VendeinRaZoR/PCI_COM_LPT/README.md

# COM и LPT контроллеры на шине PCI (2017-2018 годов разработки)

**Краткое описание**

COM и LPT (только в версии 1) контроллеры на шине PCI. Представляют собой функциональные аналоги 
китайских контроллеров типа Orient (только с одним COM портом), выполненные на, как зарубежной,
так и отечественной микросхемах ПЛИС.

Вся документация находится в папках Schematics, а Gerber файлы в папках Gerber. Документации на 
отечественные ПЛИС находятся в папке воронеж ктц.

Проект для импортной ПЛИС EP3CE10 Cyclone III для Quartus 13.0sp1 - в папке Cyclone III

Проект для отечественной ПЛИС 5576ХС4Т для Quartus 9.0sp2 - в папке XC4T

Аналог для версии 1 (WCH CH353):

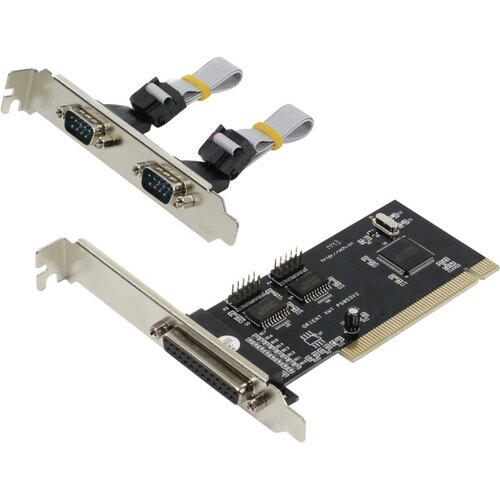
[picture p1: README.images/1.jpg]


Аналог для версии 2 (WCH CH351/353):

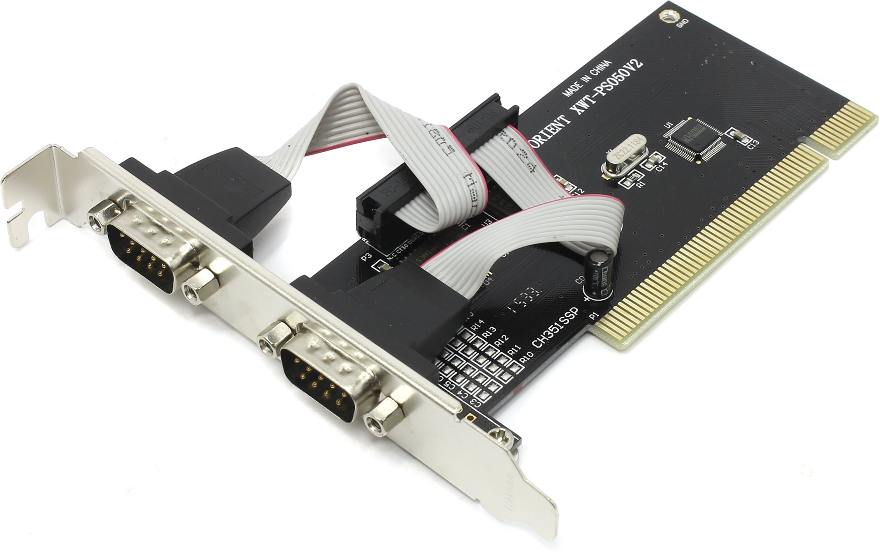
[picture p2: README.images/2.jpg]


Драйвера также используются исключительно от данных контроллеров и находятся в папке Drivers.

Внешний вид аналога на импортной ПЛИС (Cyclone III):

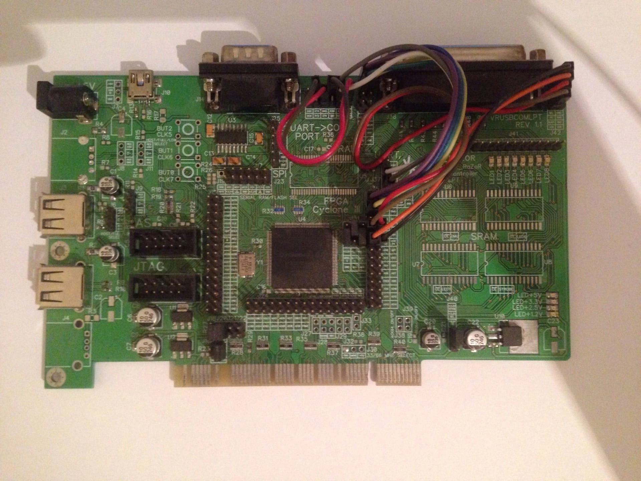
[picture p3: README.images/3.jpg]


Внешний вид аналога на отечественной ПЛИС (5576ХС4Т, Воронеж, КТЦ Электроника):

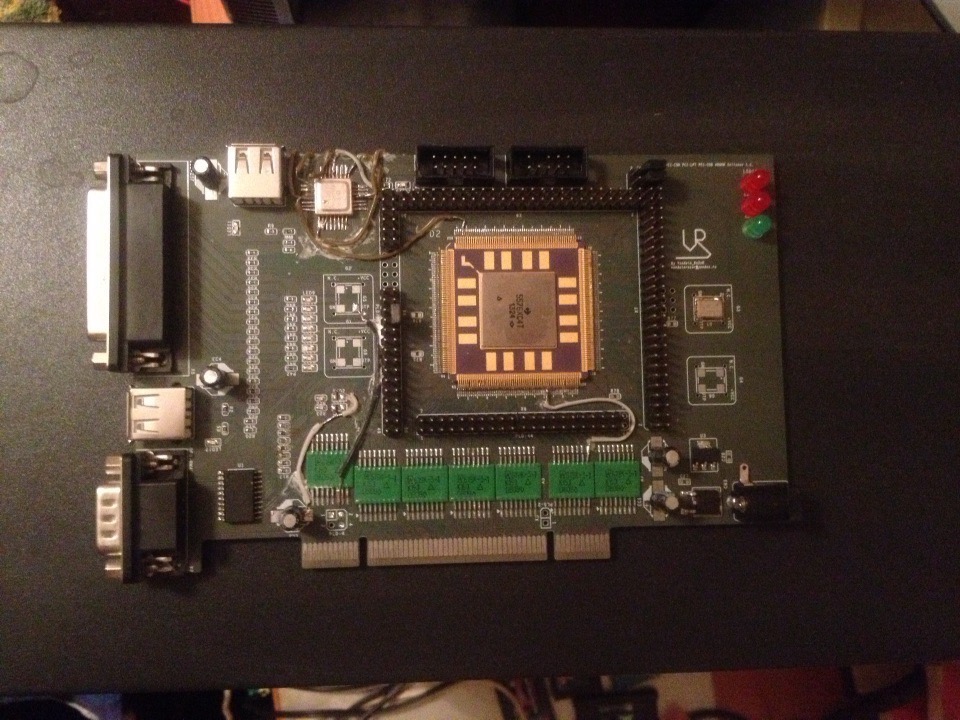
[picture p4: README.images/4.jpg]

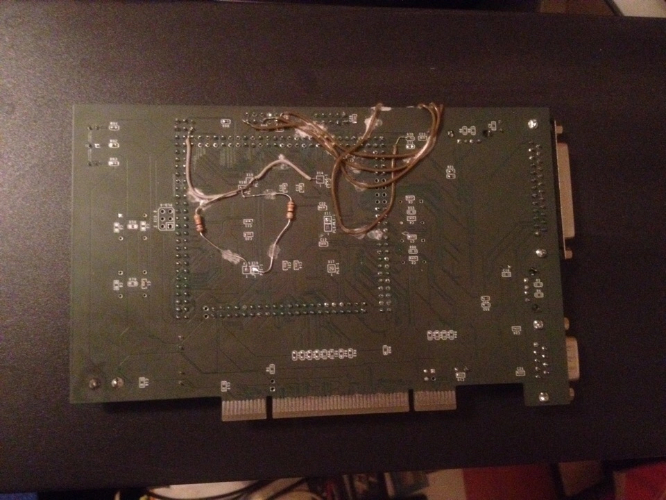
[picture p5: README.images/5.jpg]

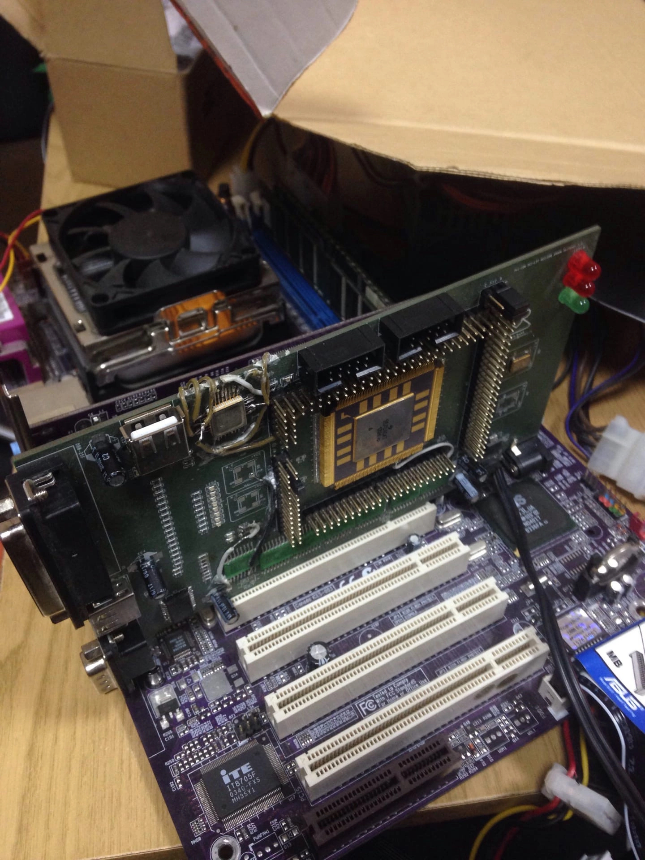
[picture p6: README.images/6.jpg]


***Видео примера работы устройства***

Watch the video (https://youtu.be/Nd93BykMgdI)
