VendeinRaZoR/PCI_COM_LPT/Schematics Cyclone III/Плакат демонстрационный.pdf

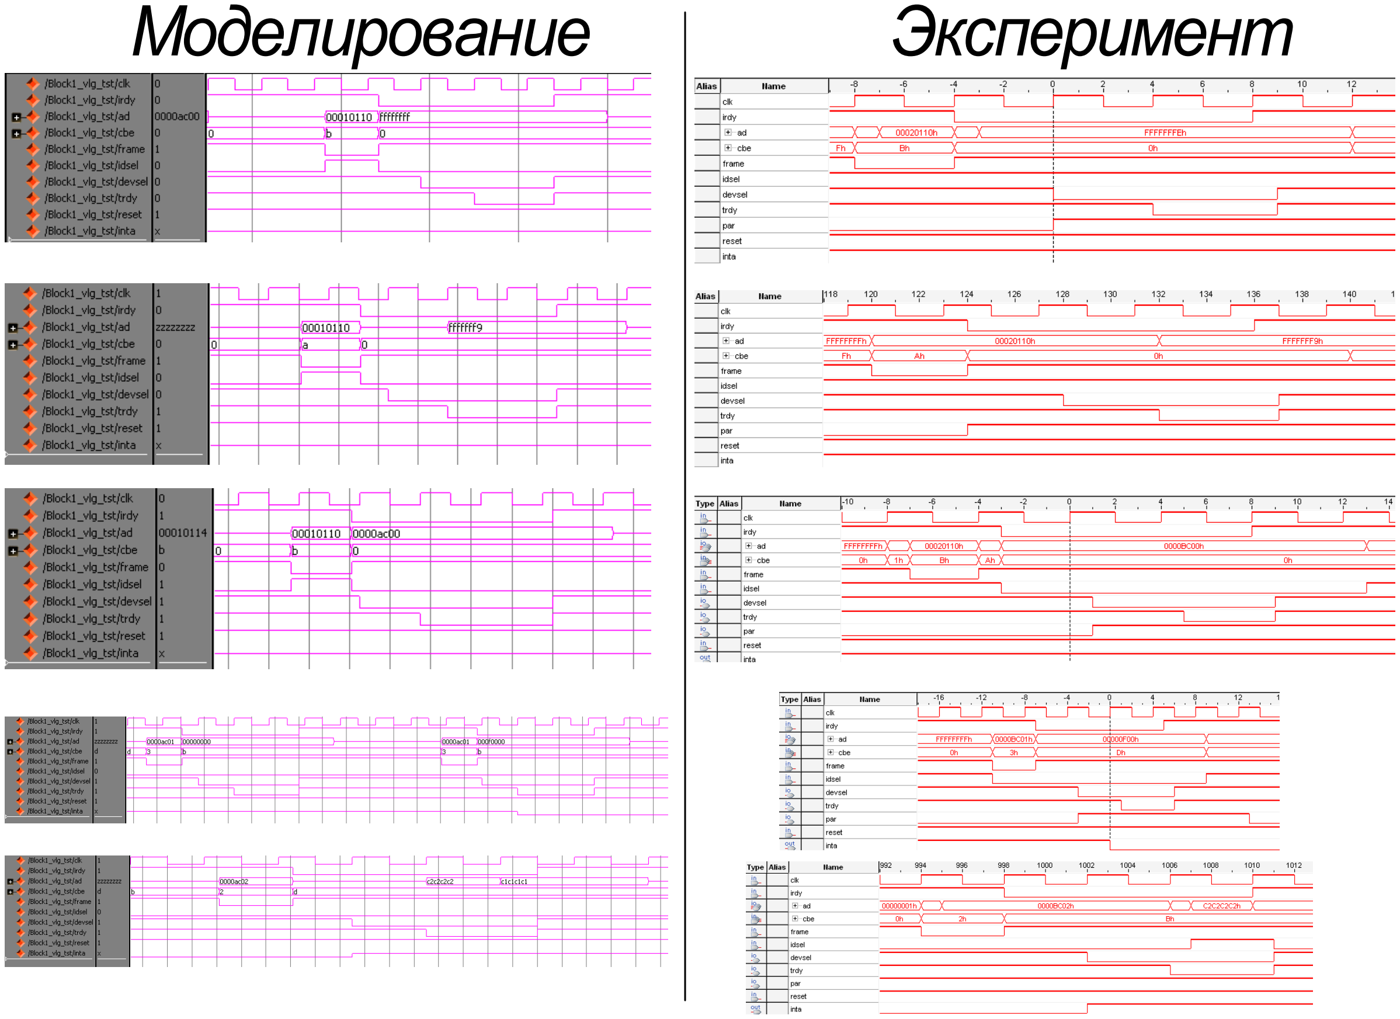
[picture p7: page 1]

Моделирование | Эксперимент
