VendeinRaZoR/PCI_COM_LPT/Schematics Cyclone III/Схема измерительного стенда.pdf

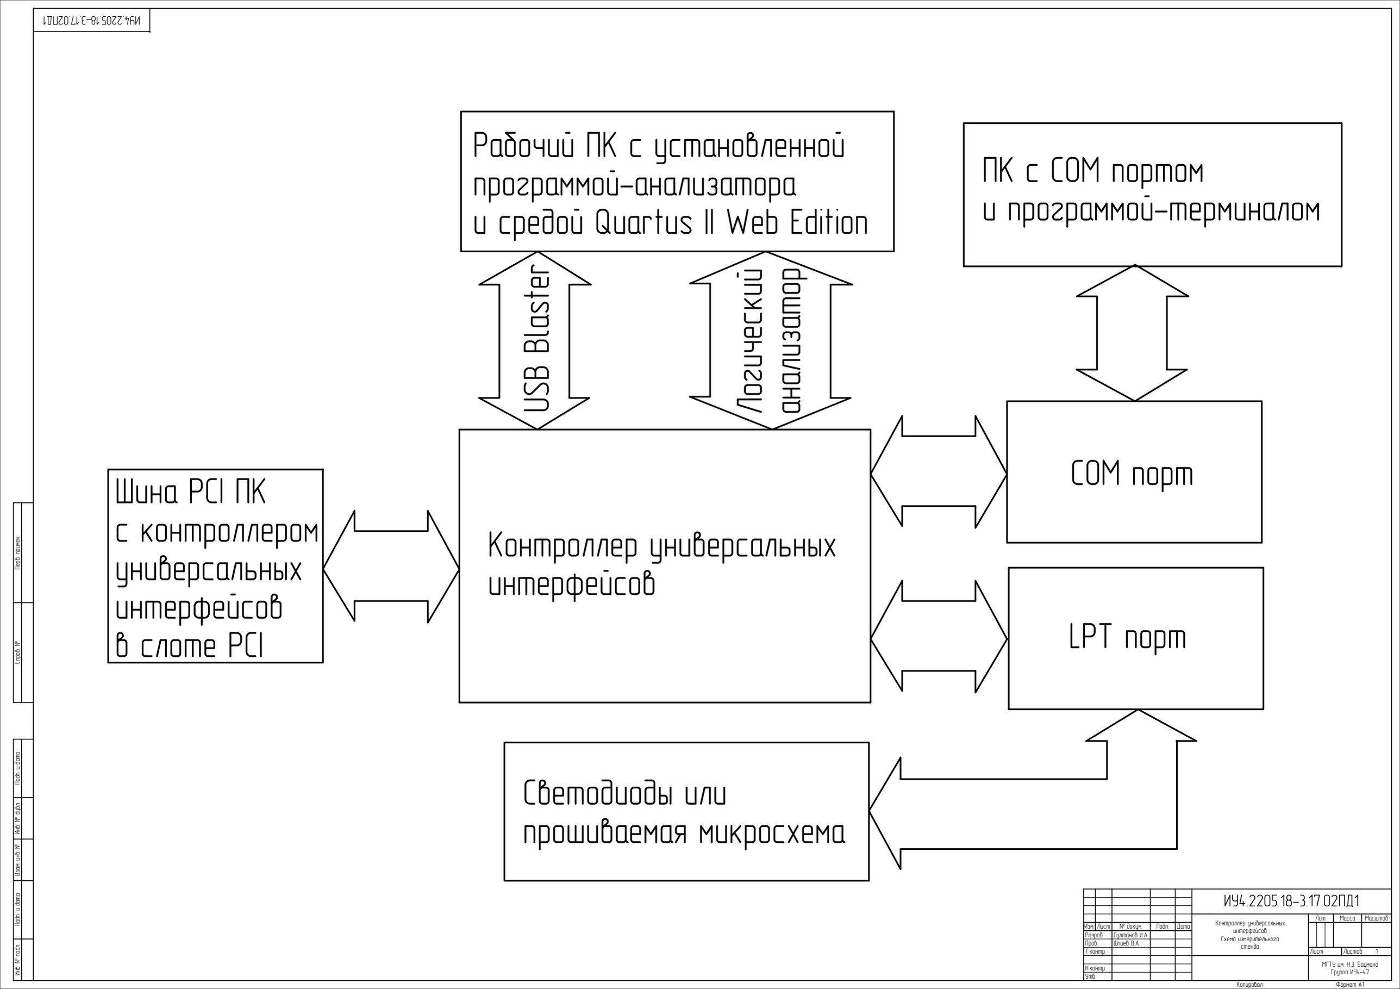
[picture p8: figure]
Ðàçðàá.; Ñóëòàíîâ È.À.; Ïðîâ.; Øïèåâ Â.À.; Ò.êîíòð.; Ëèñò; Ëèñòîâ 1; Èçì.; ¹ äîêóì.; Ïîäï.; Äàòà; Í.êîíòð. Óòâ.; Êîïèðîâàë:; Ôîðìàò À1; Êîíòðîëëåð óíèâåðñàëüíûõ èíòåðôåéñîâ; Øèíà PCI ÏÊ ñ êîíòðîëëåðîì óíèâåðñàëüíûõ èíòåðôåéñîâ â ñëîòå PCI; COM ïîðò; LPT ïîðò; Ðàáî÷èé ÏÊ ñ óñòàíîâëåííîé ïðîãðàììîé-àíàëèçàòîðà è ñðåäîé Quartus II Web Edition; USB Blaster; Ëîãè÷åñêèé; àíàëèçàòîð; ÏÊ ñ COM ïîðòîì è ïðîãðàììîé-òåðìèíàëîì; Ñâåòîäèîäû èëè ïðîøèâàåìàÿ ìèêðîñõåìà

| | | | | Êîíòðîëëåð óíèâåðñàëüíûõ èíòåðôåéñîâ Ñõåìà èçìåðèòåëüíîãî ñòåíäà | Ëèò. | Ìàññà | Ìàñøòàá
| | | | | ÌÃÒÓ èì. Í.Ý. Áàóìàíà Ãðóïïà ÈÓ4-47

Èíâ. ¹ ïîäë. Ïîäï. è äàòà Âçàì. èíâ. ¹ Èíâ. ¹ äóáë. Ïîäï. è äàòà Ñïðàâ. ¹ Ïåðâ. ïðèìåí.
