VendeinRaZoR/PCI_COM_LPT/воронеж ктц/Таблица соответствия выводов ПЛИС 5576ХС4Т и EPF10K200S.pdf

Таблица 1 – Соответствие выводов ПЛИС 5576ХС4Т и EPF10K200S

Номер
ячейки
СПС

Номер
вывода
ПЛИС
EPF10K200S
в корпусе
RQFP240

Номер
вывода
ПЛИС
5576ХС4Т
в корпусе
4244.256–3

Обозначение
вывода
Тип вывода | Статус вывода
1 | 2 | 3 | 4 | 5 | 6
– | 1 | 65 | TCK | Вход | Служебный
0 | 2 | 66 | CONF_DONE | Вход/выход с открытым стоком | Служебный
1 | 3 | 67 | nCEO | Выход | Служебный
– | 4 | 68 | TDO | Выход с тремя состояниями | Служебный
3 | 6 | 69 | I/O49 | Вход/выход | Пользовательский
4 | 11 | 74 | I/O53 | Вход/выход | Пользовательский
5 | 7 | 71 | I/O50 | Вход/выход | Пользовательский
6 | 8 | 72 | I/O51 | Вход/выход | Пользовательский
8 | 9 | 73 | I/O52 | Вход/выход | Пользовательский
17 | 13 | 77 | I/O54 | Вход/выход | Пользовательский
20 | 14 | 78 | I/O55 | Вход/выход | Пользовательский
26 | 17 | 80 | I/O56 | Вход/выход | Пользовательский
30 | 18 | 82 | I/O57 | Вход/выход | Пользовательский
33 | 19 | 83 | I/O58 | Вход/выход | Пользовательский
36 | 21 | 85 | I/O59 | Вход/выход | Пользовательский
45 | 23 | 86 | I/O60 | Вход/выход | Пользовательский
47 | 24 | 88 | I/O61 | Вход/выход | Пользовательский
50 | 25 | 89 | I/O62 | Вход/выход | Пользовательский
52 | 26 | 90 | I/O63 | Вход/выход | Пользовательский
59 | 28 | 91 | I/O64 | Вход/выход | Пользовательский
60 | 29 | 93 | I/O65 | Вход/выход | Пользовательский
63 | 30 | 94 | I/O66 | Вход/выход | Пользовательский
64 | 31 | 95 | I/O67 | Вход/выход | Пользовательский
69 | 33 | 98 | I/O68 | Вход/выход | Пользовательский
70 | 34 | 100 | I/O69 | Вход/выход | Пользовательский

Продолжение таблицы 1

1 | 2 | 3 | 4 | 5 | 6
74 | 35 | 101 | I/O70 | Вход/выход | Пользовательский
76 | 36 | 102 | I/O71 | Вход/выход | Пользовательский
82 | 38 | 104 | I/O72 | Вход/выход | Пользовательский
85 | 39 | 105 | I/O73 | Вход/выход | Пользовательский
92 | 41 | 107 | I/O74 | Вход/выход | Пользовательский
97 | 43 | 109 | I/O75 | Вход/выход | Пользовательский
99 | 44 | 110 | I/O76 | Вход/выход | Пользовательский
103 | 45 | 111 | I/O77 | Вход/выход | Пользовательский
104 | 46 | 112 | I/O78 | Вход/выход | Пользовательский
108 | 48 | 114 | I/O79 | Вход/выход | Пользовательский
112 | 49 | 115 | I/O80 | Вход/выход | Пользовательский
114 | 50 | 116 | I/O81 | Вход/выход | Пользовательский
117 | 51 | 117 | I/O82 | Вход/выход | Пользовательский
119 | 53 | 118 | I/O83 | Вход/выход | Пользовательский
121 | 54 | 120 | I/O84 | Вход/выход | Пользовательский
127 | 55 | 121 | I/O85 | Вход/выход | Пользовательский
128 | 56 | 122 | I/O86 | Вход/выход | Пользовательский
– | 58 | 125 | TMS | Вход | Служебный
– | 59 | 126 | TRST | Вход | Служебный
132 | 60 | 127 | nSTATUS | Вход/выход с открытым стоком | Служебный
– | – | 128 | ERR | Вход/выход с открытым стоком

Служебный

134 | 61 | 131 | I/O87 | Вход/выход | Пользовательский
135 | 62 | 130 | I/O88 | Вход/выход | Пользовательский
139 | 63 | 133 | I/O89 | Вход/выход | Пользовательский
141 | 64 | 132 | I/O90 | Вход/выход | Пользовательский
143 | 65 | 135 | I/O91 | Вход/выход | Пользовательский
145 | 66 | 134 | I/O92 | Вход/выход | Пользовательский
147 | 67 | 137 | I/O93 | Вход/выход | Пользовательский
149 | 68 | 136 | I/O94 | Вход/выход | Пользовательский
152 | 70 | 139 | I/O95 | Вход/выход | Пользовательский

1 | 2 | 3 | 4 | 5 | 6
156 | 71 | 138 | I/O96 | Вход/выход | Пользовательский
159 | 72 | 141 | I/O97 | Вход/выход | Пользовательский
166 | 73 | 140 | I/O98 | Вход/выход | Пользовательский
167 | 74 | 143 | I/O99 | Вход/выход | Пользовательский
168 | 75 | 142 | I/O100 | Вход/выход | Пользовательский
169 | 78 | 144 | I/O101 | Вход/выход | Пользовательский
171 | 79 | 147 | I/O102 | Вход/выход | Пользовательский
173 | 80 | 149 | I/O103 | Вход/выход | Пользовательский
175 | 81 | 148 | I/O104 | Вход/выход | Пользовательский
177 | 82 | 150 | I/O105 | Вход/выход | Пользовательский
179 | 83 | 152 | I/O106 | Вход/выход | Пользовательский
180 | 84 | 153 | I/O107 | Вход/выход | Пользовательский
181 | 86 | 154 | I/O108 | Вход/выход | Пользовательский
182 | 87 | 155 | I/O109 | Вход/выход | Пользовательский
183 | 88 | 156 | I/O110 | Вход/выход | Пользовательский
185 | 90 | 159 | INPUT2 | Вход | Пользовательский
186 | 91 | 160 | CLOCK1 | Вход | Пользовательский
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
5 При создании проектов в MAX+PLUS II или Quartus II выводы 12, 15, 126, 163, 175 ПЛИС EPF10K200SRC240–3 не используют.

Часть выводов ПЛИС является выводами двойного назначения, кото-рые могут использоваться, как в процессе конфигурирования, так и в пользо-вательском режиме. Используемые обозначения для этих выводов – DATA [7...1], RDYnBUSY, DEV_CLRn, DEV_OE, nRS, nWS, CS, nCS, CLKUSR, INIT_DONE являются общепринятыми.

Таблица 2 − Соответствие обозначений выводов двойного назначения для ПЛИС 5576ХС4Т

Обозначение вывода в настоящей инструкции | Обозначение вывода на УГО | Номер вывода в корпусе 4244.256–3 | Номер вывода в корпусе RQFP240
DATA1 | I/O0 | 1 | 181
DATA2 | I/O1 | 3 | 182
DATA3 | I/O2 | 2 | 183
DATA4 | I/O4 | 7 | 185
DATA5 | I/O5 | 6 | 186
DATA6 | I/O6 | 8 | 188
DATA7 | I/O7 | 11 | 190
RDYnBUSY | I/O60 | 86 | 23
DEV_CLRn | I/O24 | 29 | 209
DEV_OE | I/O25 | 37 | 213
nRS | I/O44 | 60 | 236
nWS | I/O46 | 62 | 238
CS | I/O47 | 61 | 239
nCS | I/O48 | 63 | 240
CLKUSR | I/O53 | 74 | 11
INIT_DONE | I/O63 | 90 | 26
