VendeinRaZoR/PCI_COM_LPT/Schematics XC4T/Cadence Allegro/pci_com_lpt.jpg

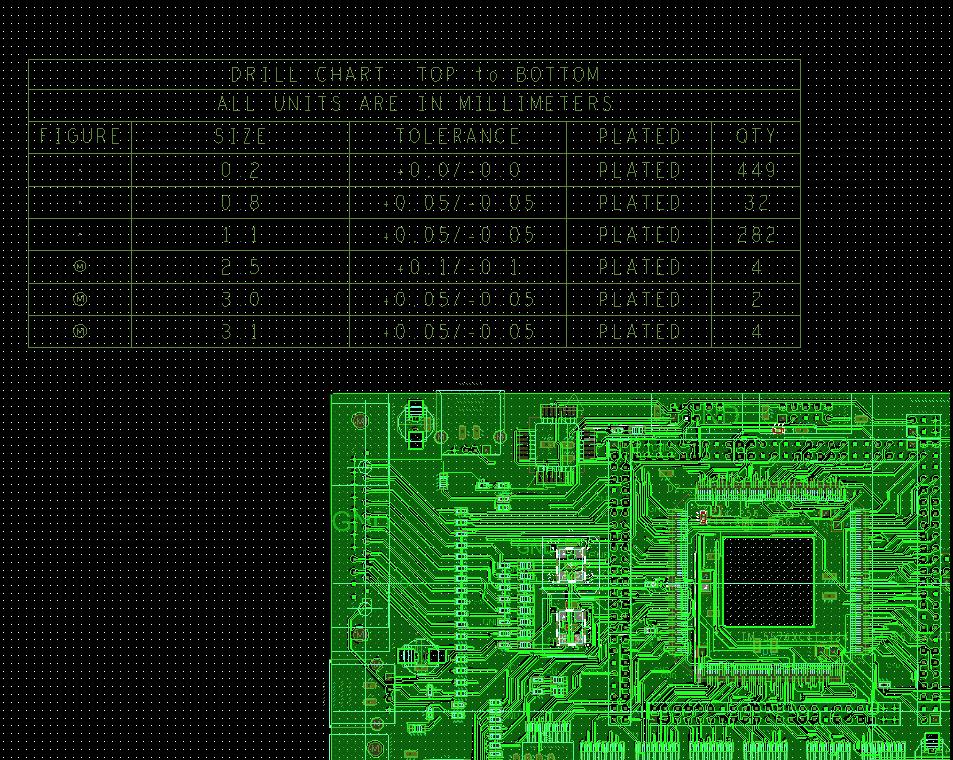
Schematics XC4T/Cadence Allegro/pci_com_lpt.jpg
