VendeinRaZoR/PCI_COM_LPT/(list of files, cad)

Other CAD files:
Version 1.0/Cyclone III/pci_usb_test/output_files/stp2_auto_stripped.stp
Version 2.0 (without LPT)/Cyclone III/pci_com_lpt_usb_eth/output_files/stp1.stp
Version 2.0 (without LPT)/Cyclone III/pci_com_lpt_usb_eth/output_files/stp1_auto_stripped.stp
Version 1.0/Cyclone III/pci_usb_test/simulation/modelsim/rtl_work/@block1/verilog.psm
Version 1.0/Cyclone III/pci_usb_test/simulation/modelsim/rtl_work/@block1_vlg_tst/verilog.psm
Version 1.0/Cyclone III/pci_usb_test/simulation/modelsim/rtl_work/@c@o@m_controller_16@c550/verilog.psm
Version 1.0/Cyclone III/pci_usb_test/simulation/modelsim/rtl_work/@l@p@t_controller_82550/verilog.psm
Version 1.0/Cyclone III/pci_usb_test/simulation/modelsim/rtl_work/@p@c@i_io/verilog.psm
Version 1.0/Cyclone III/pci_usb_test/simulation/modelsim/rtl_work/@p@c@i_target_controller/verilog.psm
Version 1.0/Cyclone III/pci_usb_test/simulation/modelsim/rtl_work/altpll0/verilog.psm
Version 1.0/Cyclone III/pci_usb_test/simulation/modelsim/rtl_work/altpll0_altpll/verilog.psm
Version 1.0/Cyclone III/pci_usb_test/simulation/modelsim/rtl_work/altpll0_altpll3/verilog.psm
Version 2.0 (without LPT)/Cyclone III/pci_com_lpt_usb_eth/simulation/modelsim/work/com_controller/verilog.psm
Version 2.0 (without LPT)/Cyclone III/pci_com_lpt_usb_eth/simulation/modelsim/work/pci_com_lpt_usb_eth/verilog.psm
Version 2.0 (without LPT)/Cyclone III/pci_com_lpt_usb_eth/simulation/modelsim/work/pci_com_lpt_usb_eth_vlg_tst/verilog.psm
Version 2.0 (without LPT)/Cyclone III/pci_com_lpt_usb_eth/simulation/modelsim/work/pci_controller/verilog.psm
