VendeinRaZoR/PCI_COM_LPT/Version 1.0/Cyclone III/pci_usb_test/pci_sample.html

Generation Report - PCI Compiler v13.0

Entity Name | pci_t32
Variation Name | pci_sample
Variation HDL | Verilog HDL
Output Directory | C:\altera_projects\pci_usb_test

File Summary
The MegaWizard interface is creating the following files in the output directory:

File | Description
pci_sample.v | A MegaCore® function variation file, which defines a Verilog HDL top-level description of the custom MegaCore function. Instantiate the entity defined by this file inside of your design. Include this file when compiling your design in the Quartus II software.
pci_sample_bb.v | Verilog HDL black-box file for the MegaCore function variation. Use this file when using a third-party EDA tool to synthesize your design.
pci_sample.bsf | Quartus® II symbol file for the MegaCore function variation. You can use this file in the Quartus II block diagram editor.
pci_sample.ppf | This XML file describes the MegaCore pin attributes to the Quartus II Pin Planner. MegaCore pin attributes include pin direction, location, I/O standard assignments, and drive strength. If you launch the megaWizard outside of the Pin Planner application, you must explicitly load this file to use Pin Planner.
pci_constraints_for_pci_sample.tcl | Tcl file for the Megacore to make device specific timing constraints. Use this to make constraints for the core to meet PCI specification timing requirement.
pci_sample_nativelink.tcl | A tcl script to assign NativeLink simulation testbench settings to the Quartus project.
pci_sample_nativelink | Directory where NativeLink simulation testbench files reside.
pci_sample.qip | Contains Quartus II project information for your MegaCore function variation.
pci_sample.html | The MegaCore function report file.

MegaCore Function Variation File Ports

Name | Direction | Width
clk | INPUT | 1
rstn | INPUT | 1
idsel | INPUT | 1
l_adi | INPUT | 32
lt_rdyn | INPUT | 1
lt_abortn | INPUT | 1
lt_discn | INPUT | 1
lirqn | INPUT | 1
cben | INPUT | 4
intan | OUTPUT | 1
serrn | OUTPUT | 1
l_adro | OUTPUT | 32
l_dato | OUTPUT | 32
l_beno | OUTPUT | 4
l_cmdo | OUTPUT | 4
lt_framen | OUTPUT | 1
lt_ackn | OUTPUT | 1
lt_dxfrn | OUTPUT | 1
lt_tsr | OUTPUT | 12
cmd_reg | OUTPUT | 7
stat_reg | OUTPUT | 7
ad | BIDIR | 32
par | BIDIR | 1
perrn | OUTPUT | 1
framen | INPUT | 1
irdyn | INPUT | 1
devseln | OUTPUT | 1
trdyn | OUTPUT | 1
stopn | OUTPUT | 1
