VendeinRaZoR/PCI_COM_LPT/Version 1.0/Cyclone III/pci_usb_test/PLLJ_PLLSPE_INFO.txt

PLL_Name	altpll0:b2v_inst3|altpll:altpll_component|altpll0_altpll3:auto_generated|pll1
PLLJITTER	36
PLLSPEmax	84
PLLSPEmin	-53
