VendeinRaZoR/PCI_COM_LPT/Version 1.0/Cyclone III/pci_usb_test/serv_req_info.txt

<internal_error>
	<executable>quartus.exe</executable>
	<sub_system>MEM</sub_system>
	<error>*** Fatal Error: Out of memory in module quartus.exe (2020 megabytes used)</error>
	<date>Sun Sep 03 02:26:55 2017</date>
	<version>Version 13.0.1 Build 232 06/12/2013 Service Pack 1 SJ Web Edition</version>
</internal_error>

<internal_error>
	<executable>quartus.exe</executable>
	<sub_system>MEM</sub_system>
	<error>*** Fatal Error: Out of memory in module quartus.exe (1947 megabytes used)</error>
	<date>Wed Jul 11 09:18:16 2018</date>
	<version>Version 13.0.0 Build 156 04/24/2013 SJ Web Edition</version>
</internal_error>
