VendeinRaZoR/PCI_COM_LPT/Version 1.0/Cyclone III/pci_usb_test/output_files/stp1.csv

Groups:
ad = | ad[31] | ad[30] | ad[29] | ad[28] | ad[27] | ad[26] | ad[25] | ad[24] | ad[23] | ad[22] | ad[21] | ad[20] | ad[19] | ad[18] | ad[17] | ad[16] | ad[15] | ad[14] | ad[13] | ad[12] | ad[11] | ad[10] | ad[9] | ad[8] | ad[7] | ad[6] | ad[5] | ad[4] | ad[3] | ad[2] | ad[1] | ad[0] | hex
cbe = | cbe[3] | cbe[2] | cbe[1] | cbe[0] | hex
PCI_controller:inst4|cbe = | PCI_controller:inst4|cbe[3] | PCI_controller:inst4|cbe[2] | PCI_controller:inst4|cbe[1] | PCI_controller:inst4|cbe[0] | hex
Data:
time unit: s | clk | irdy | ad | ad[31] | ad[30] | ad[29] | ad[28] | ad[27] | ad[26] | ad[25] | ad[24] | ad[23] | ad[22] | ad[21] | ad[20] | ad[19] | ad[18] | ad[17] | ad[16] | ad[15] | ad[14] | ad[13] | ad[12] | ad[11] | ad[10] | ad[9] | ad[8] | ad[7] | ad[6] | ad[5] | ad[4] | ad[3] | ad[2] | ad[1] | ad[0] | cbe | cbe[3] | cbe[2] | cbe[1] | cbe[0] | trdy | devsel | frame | idsel | reset | par | PCI_controller:inst4|first | PCI_controller:inst4|state.WRITE_IO | PCI_controller:inst4|state.READ_IO | PCI_controller:inst4|state.IDLE | PCI_controller:inst4|state.CONFIGURATION_WRITE | PCI_controller:inst4|state.CONFIGURATION_READ | PCI_controller:inst4|cbe | PCI_controller:inst4|cbe[3] |
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
