VendeinRaZoR/PCI_COM_LPT/Version 1.0/Cyclone III/pci_usb_test/Block1.jpg

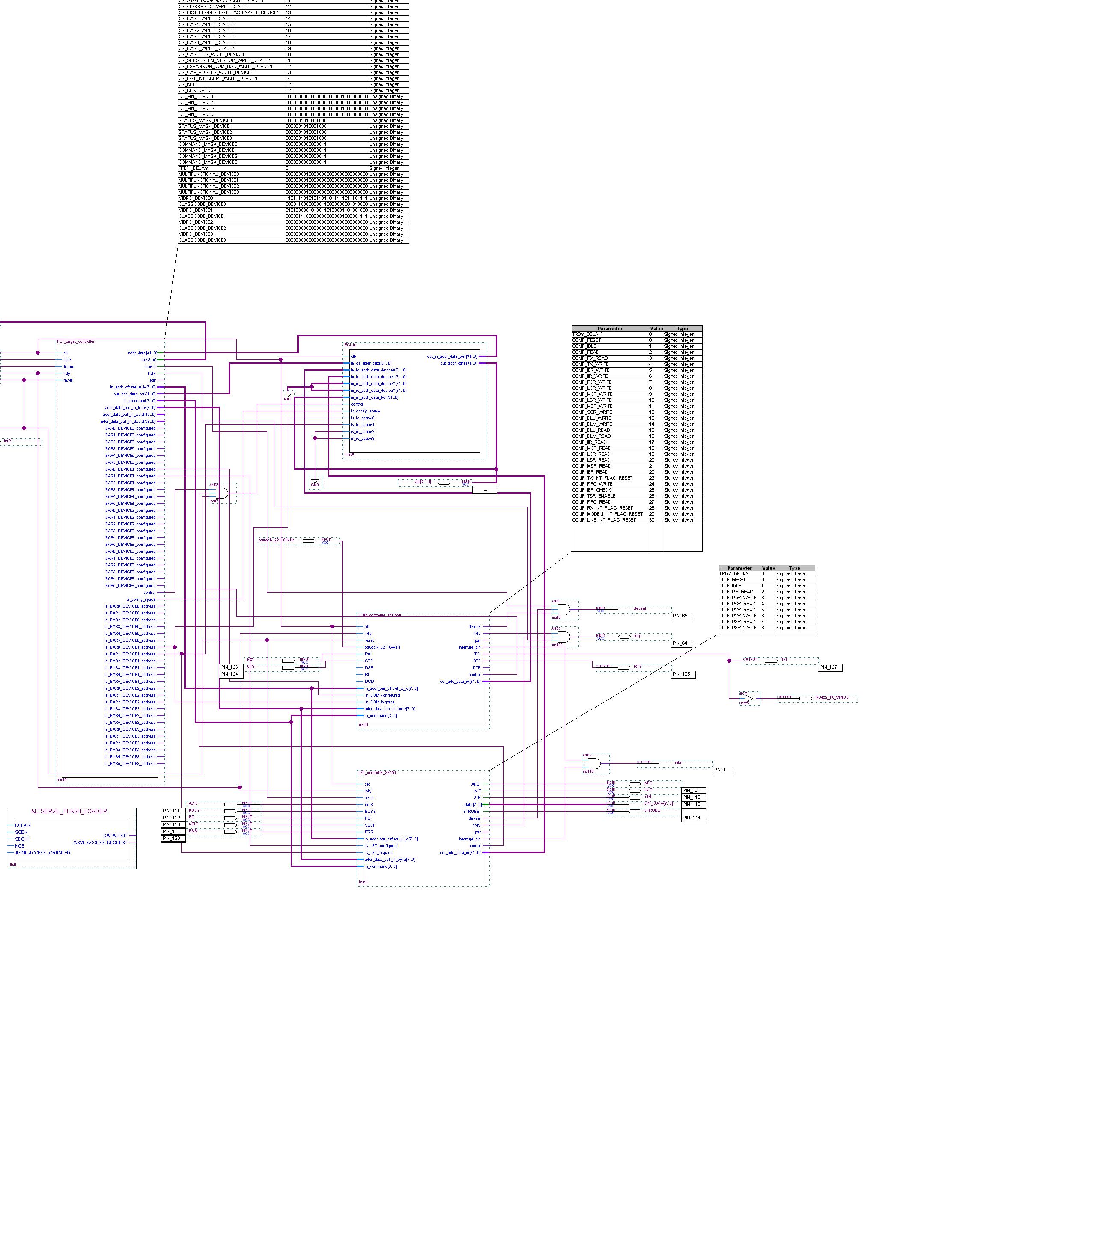
Version 1.0/Cyclone III/pci_usb_test/Block1.jpg
