VendeinRaZoR/PCI_COM_LPT/Version 1.0/Cyclone III/pci_usb_test/output_files/stp1.jpg

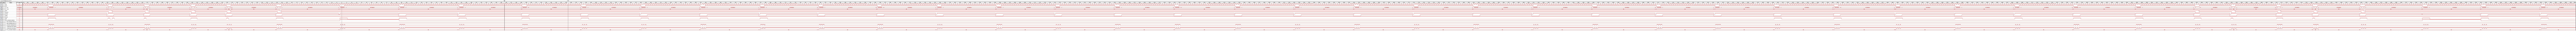
Version 1.0/Cyclone III/pci_usb_test/output_files/stp1.jpg
