VendeinRaZoR/PCI_COM_LPT/Version 1.0/Cyclone III/pci_usb_test/PCI_io_inst8.jpg

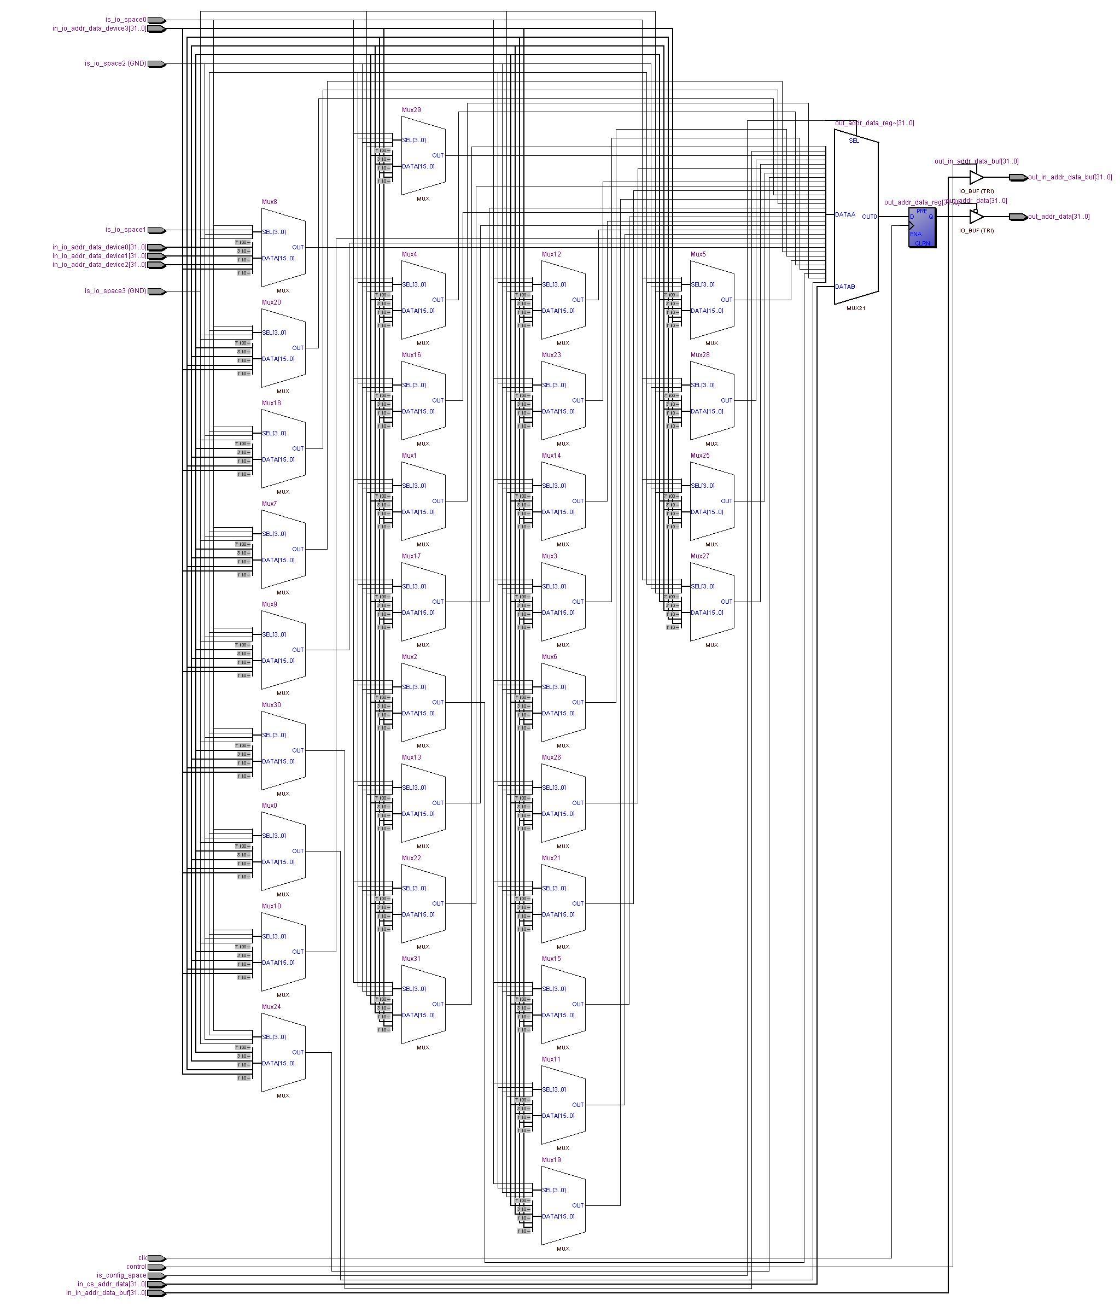
Version 1.0/Cyclone III/pci_usb_test/PCI_io_inst8.jpg
