VendeinRaZoR/PCI_COM_LPT/Version 1.0/Cyclone III/pci_usb_test/PCI_target_controller.jpg

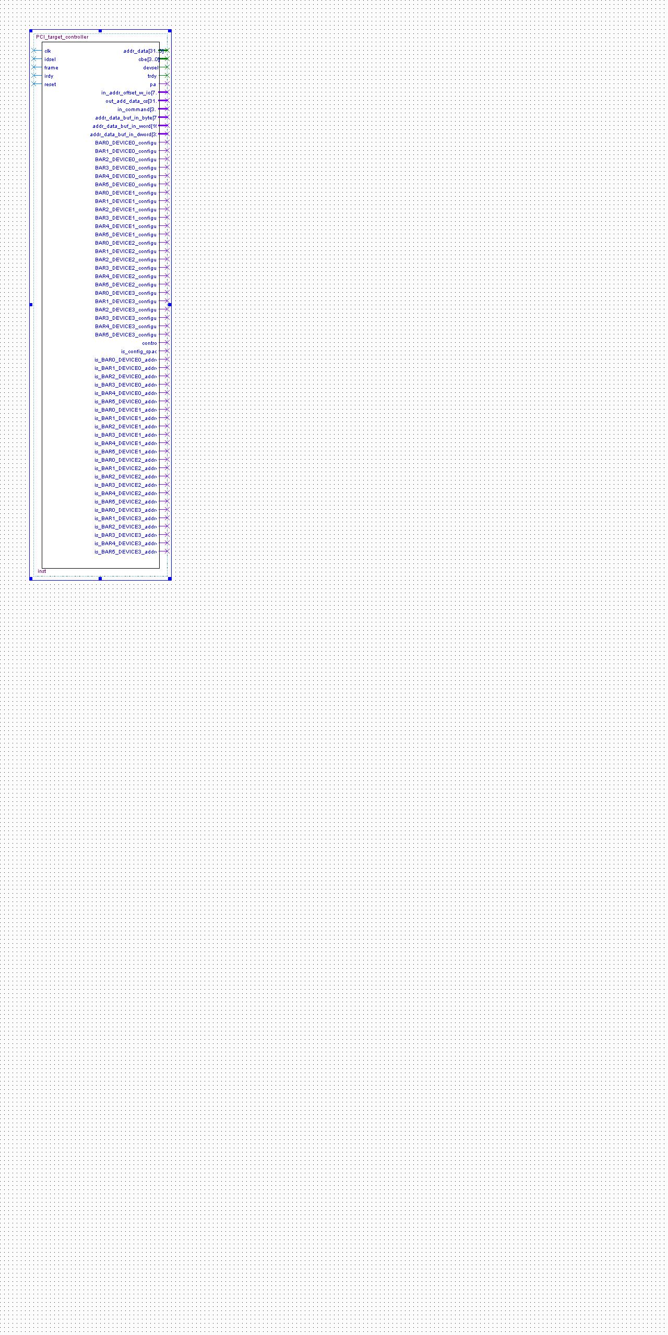
Version 1.0/Cyclone III/pci_usb_test/PCI_target_controller.jpg
