VendeinRaZoR/PCI_COM_LPT/Version 1.0/Cyclone III/pci_usb_test/simulation/modelsim/wave.bmp

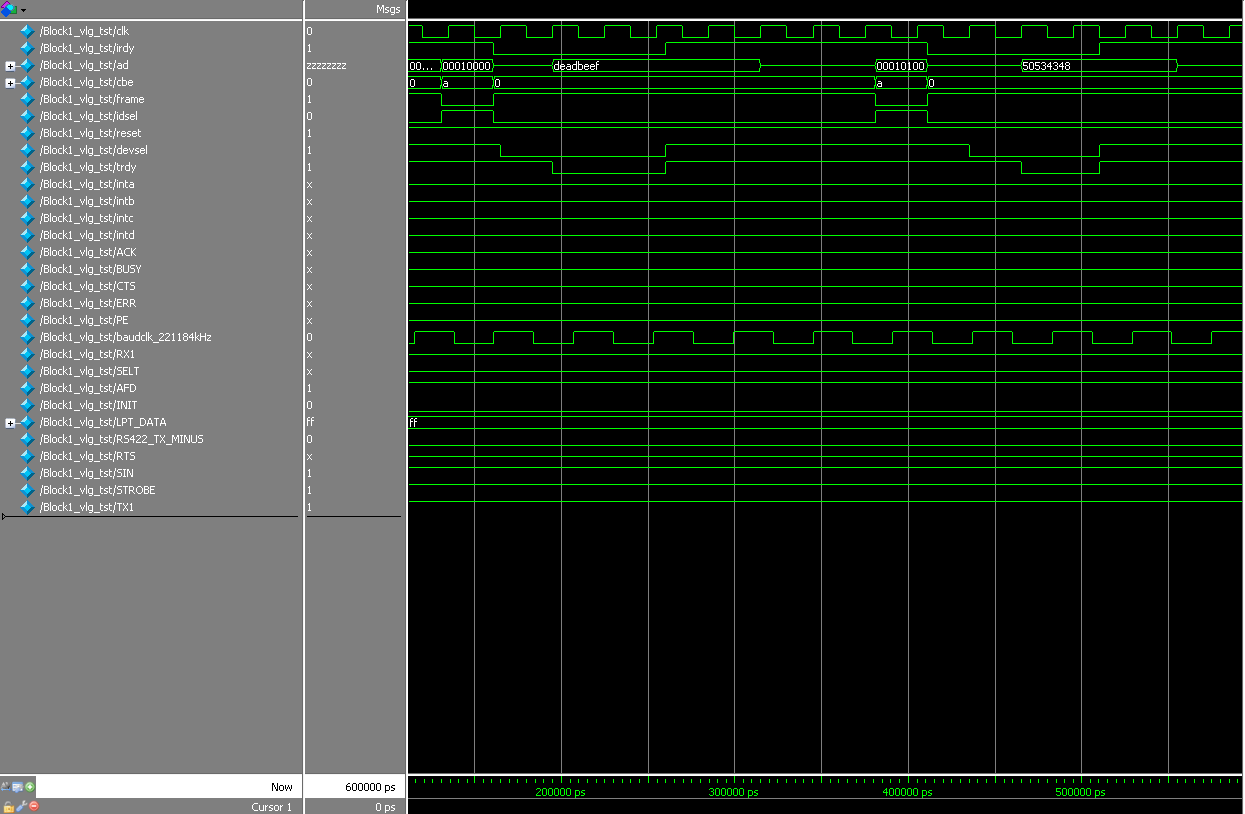
Version 1.0/Cyclone III/pci_usb_test/simulation/modelsim/wave.bmp
