VendeinRaZoR/PCI_COM_LPT/Schematics Cyclone III/Схема электрическая принципиальная 1.pdf

9 | nSTATUS 10 | IO 11 | IO 15 | TDI 16 | TCK 18 | TMS 20 | TDO 22 | CLK0 23 | CLK1 24 | CLK2 25 | CLK3 28 | IO 30 | IO 31 | IO 32 | IO 33 | IO 34 | IO

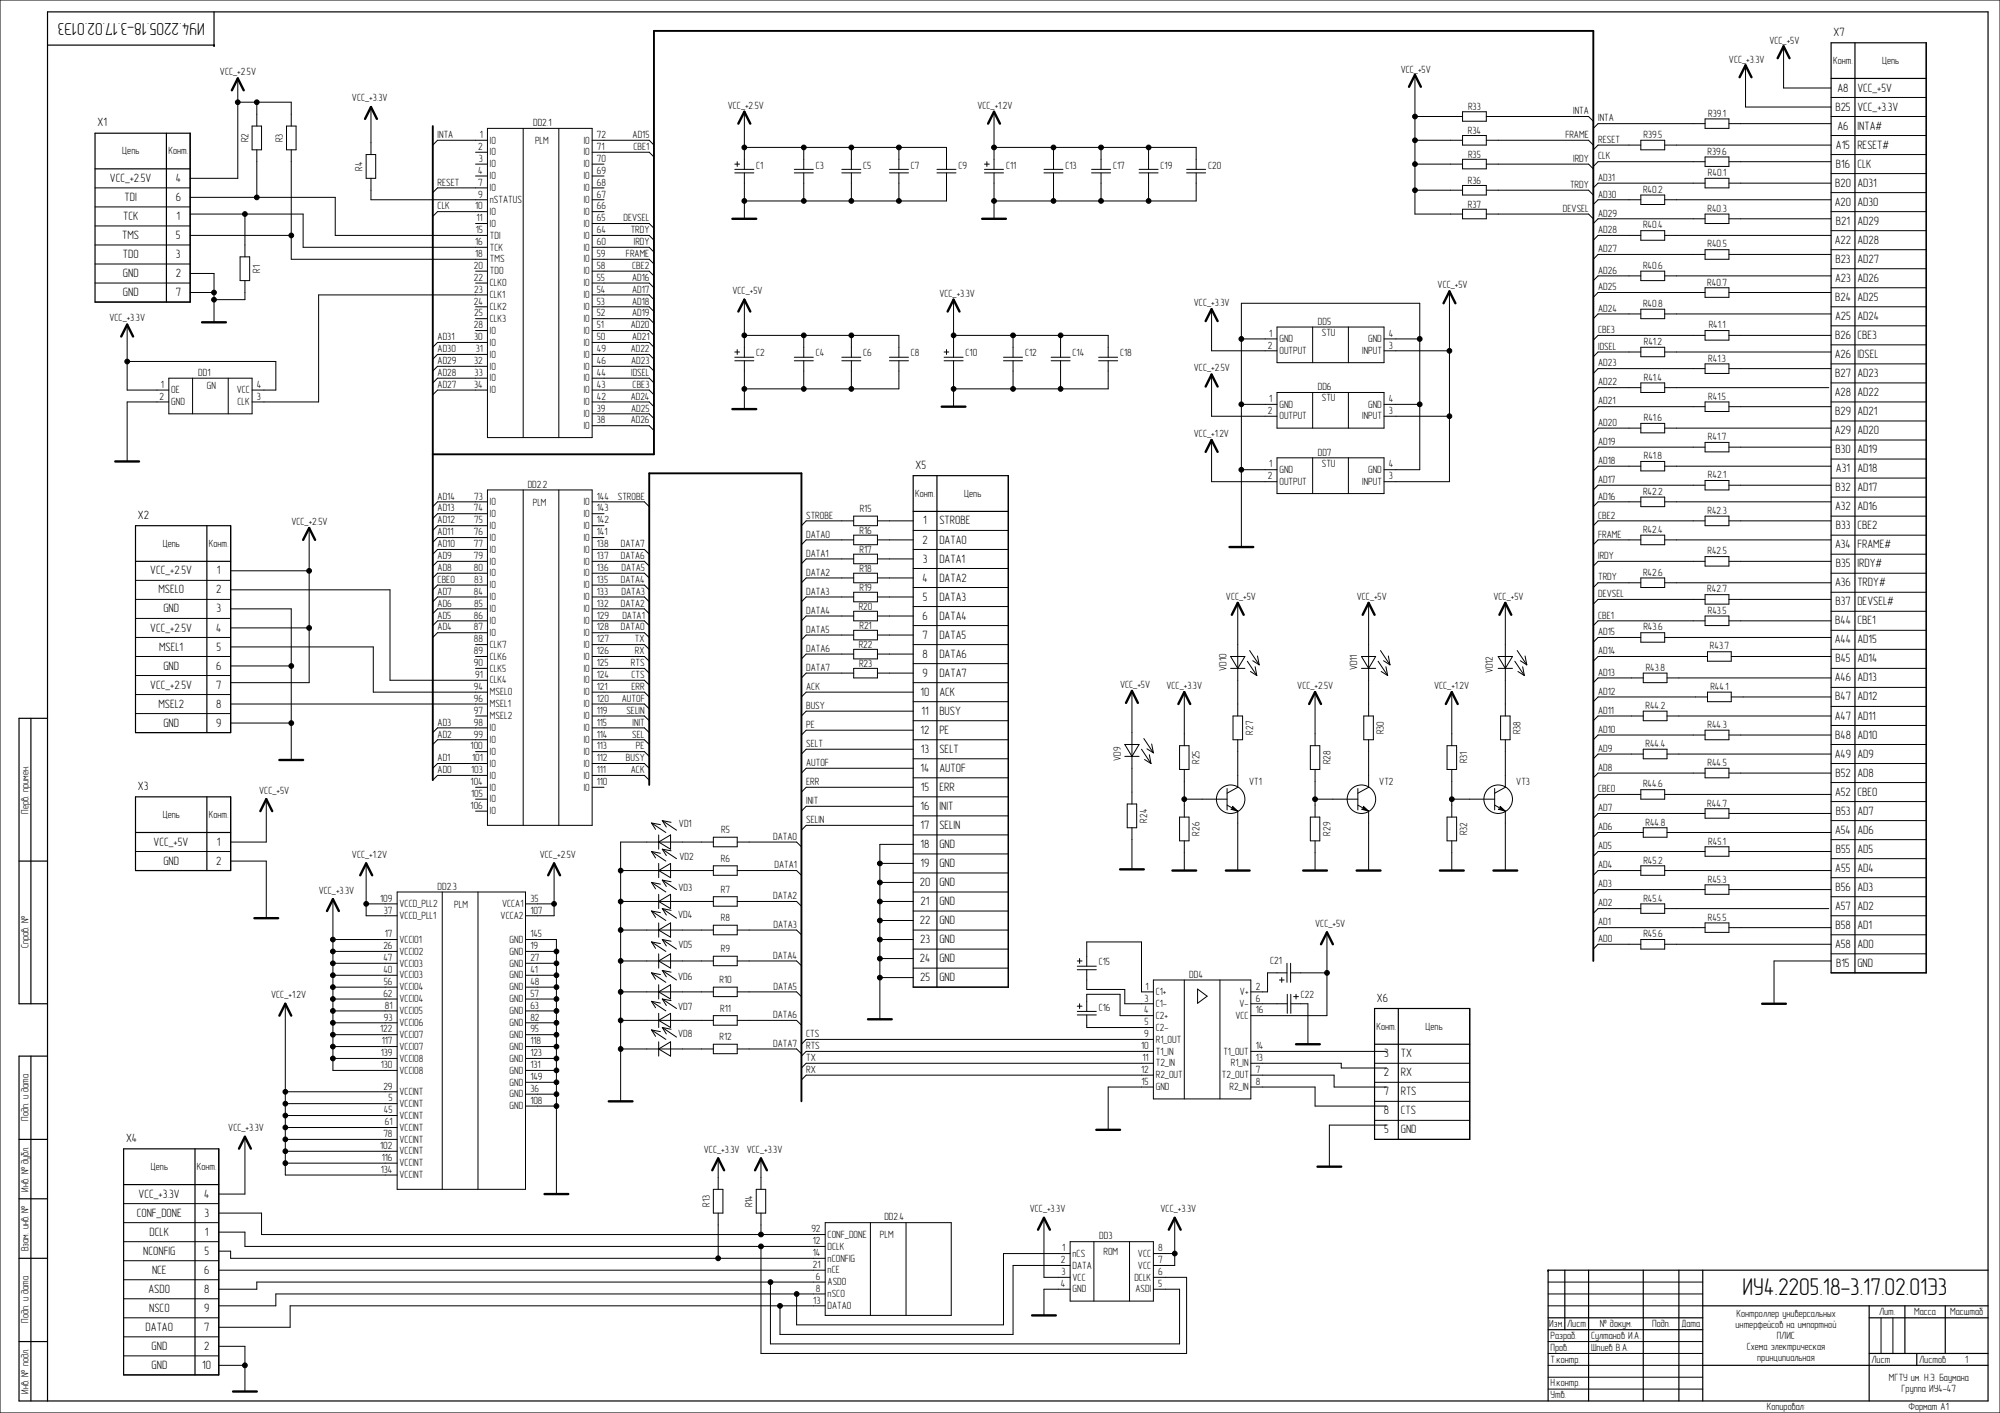
[picture p15: page 1]

Êîíò. | Öåïü

A8 | VCC_+5V
B25 | VCC_+3.3V
A6 | INTA#
A15 | RESET#
B16 | CLK
B20 | AD31

PLM

Öåïü | Êîíò.

TDI | 6
TCK | 1
TMS | 5
TDO | 3
GND | 2

B21 | AD29
A22 | AD28
B23 | AD27
A23 | AD26
B24 | AD25

60 IO IRDY | R40.5

A29 | AD20
B30 | AD19

B32 | AD17
A32 | AD16
B33 | CBE2
A34 | FRAME#
B35 | IRDY#
A36 | TRDY#

1 | STROBE
2 | DATA0
3 | DATA1
4 | DATA2

VCC_+2.5V | 1
MSEL0 | 2
GND | 3
VCC_+2.5V | 4

B37 | DEVSEL#
B44 | CBE1
A44 | AD15
B45 | AD14
A46 | AD13

6 | DATA4
7 | DATA5
8 | DATA6
9 | DATA7

GND | 6
VCC_+2.5V | 7
MSEL2 | 8

B47 | AD12
A47 | AD11
B48 | AD10
A49 | AD9
B52 | AD8

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

A52 | CBE0
B53 | AD7
A54 | AD6
B55 | AD5
A55 | AD4
B56 | AD3

17 | SELIN
18 | GND
19 | GND

24 | GND
25 | GND

VCC_+3.3V | 4
CONF_DONE | 3

NCE | 6
ASDO | 8
NSCO | 9

Êîíòðîëëåð óíèâåðñàëüíûõ èíòåðôåéñîâ íà èìïîðòíîé ÏËÈÑ Ñõåìà ýëåêòðè÷åñêàÿ ïðèíöèïèàëüíàÿ | Ëèò. | Ìàññà | Ìàñøòàá

Ðàçðàá. | Ñóëòàíîâ È.À.
Ïðîâ. | Øïèåâ Â.À.
Ò.êîíòð. | | Ëèñò | Ëèñòîâ 1

GND | 10

Í.êîíòð.
Óòâ.

ÌÃÒÓ èì. Í.Ý. Áàóìàíà Ãðóïïà ÈÓ4-47
