VendeinRaZoR/PCI_COM_LPT/Schematics XC4T/Схема электрическая принципиальная 2.pdf

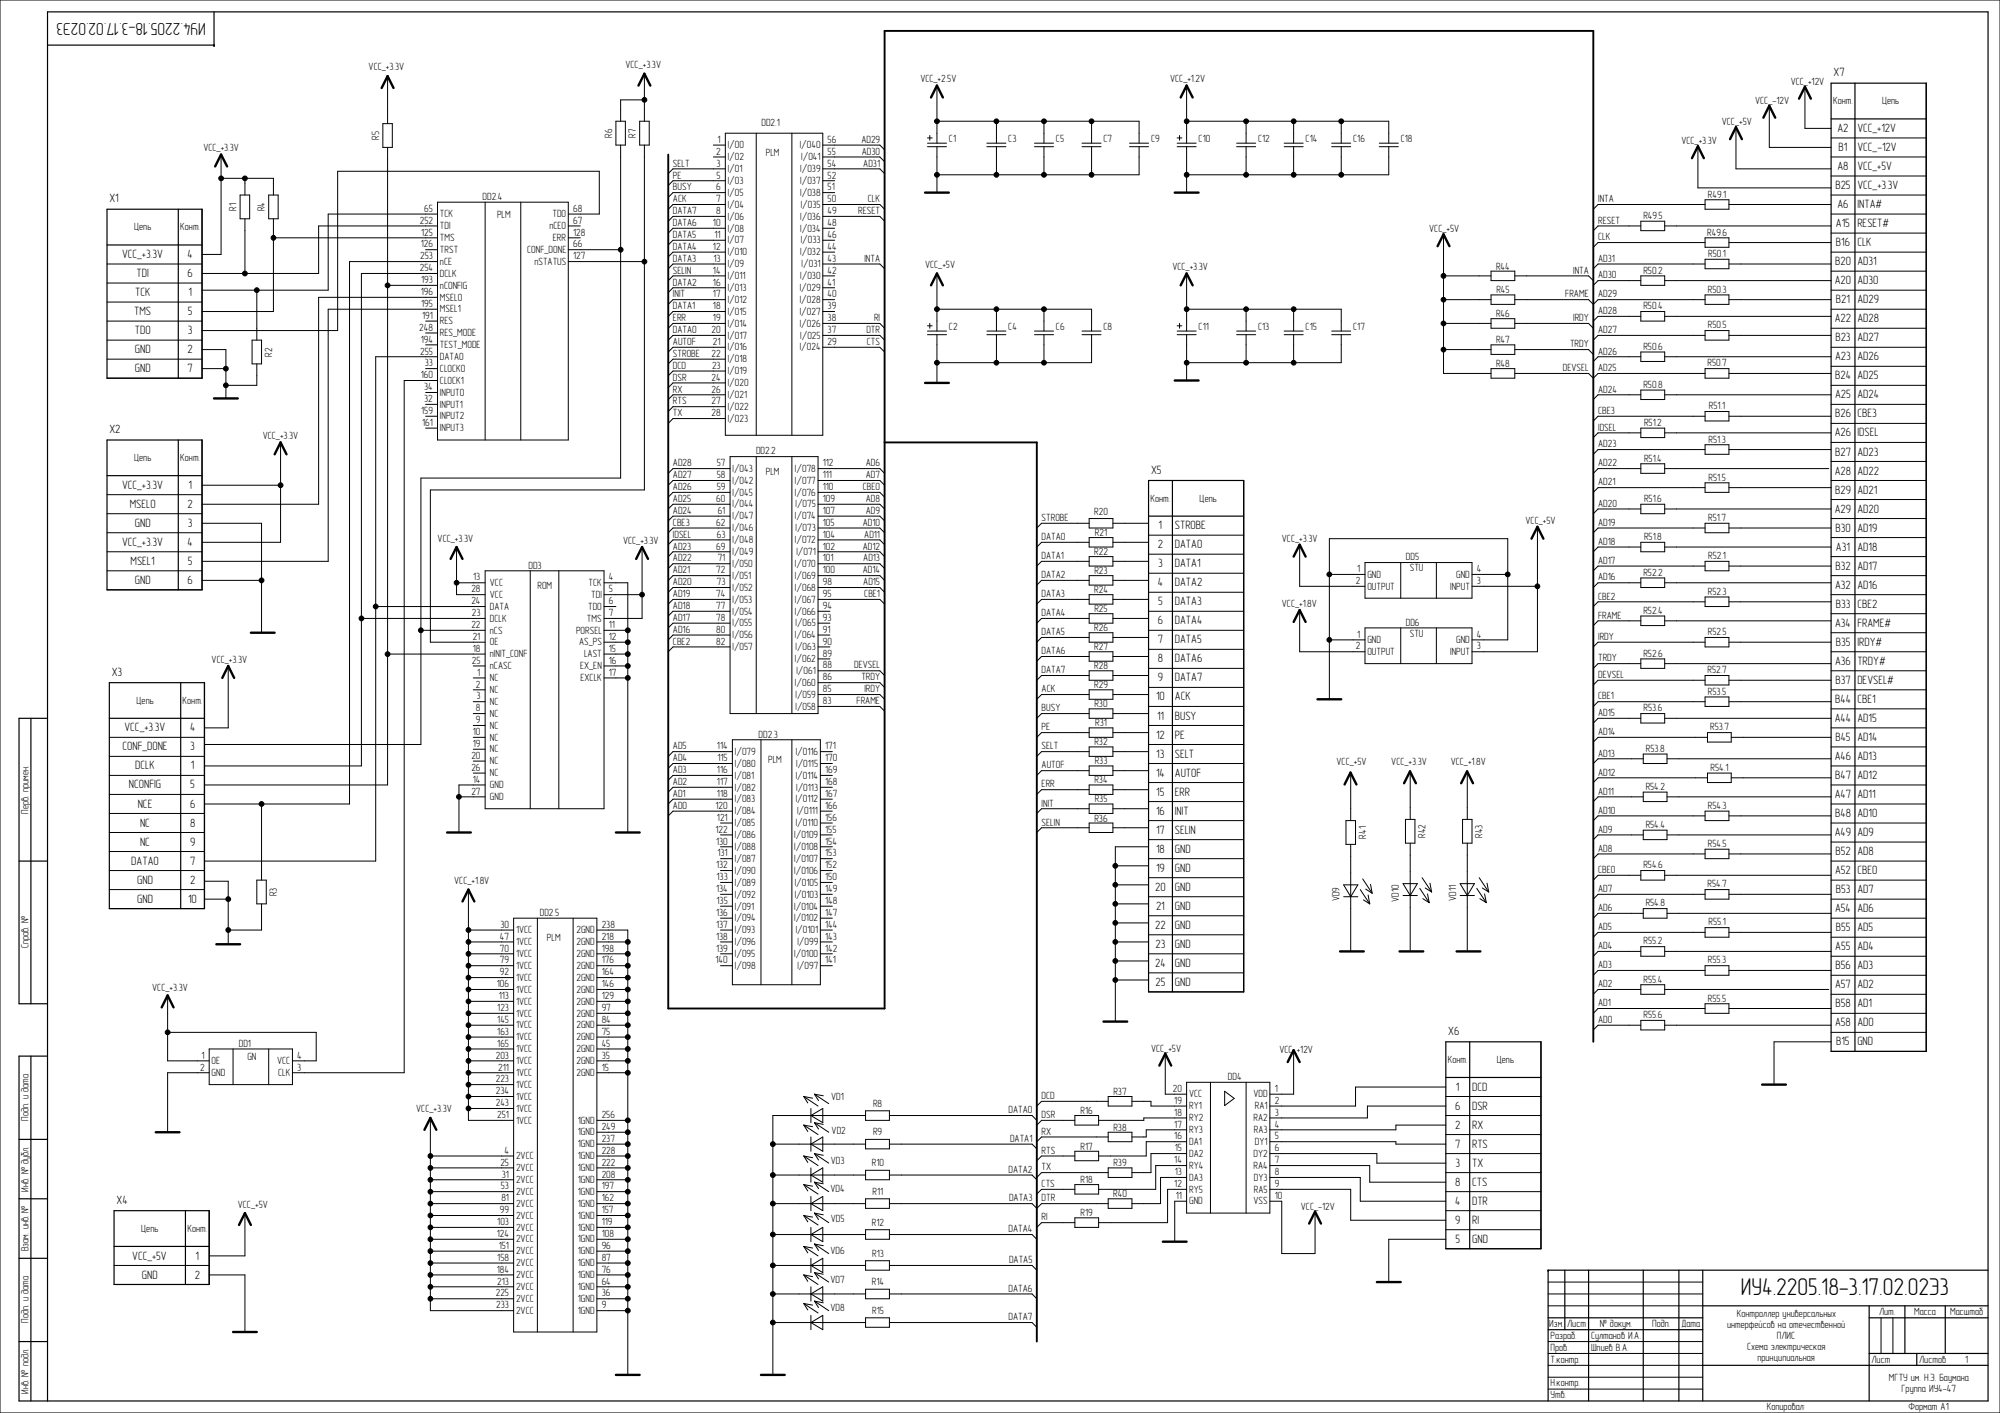
[picture p16: page 1]

Êîíò. | Öåïü

A2 | VCC_+12V
B1 | VCC_-12V
A8 | VCC_+5V
B25 | VCC_+3.3V
A6 | INTA#
A15 | RESET#
B16 | CLK
B20 | AD31

DD2.4
PLM

Öåïü | Êîíò.

VCC_+3.3V | 4
TDI | 6
TCK | 1
TMS | 5

A20 | AD30
B21 | AD29
A22 | AD28

GND | 2
GND | 7

A23 | AD26
B24 | AD25
A25 | AD24
B26 | CBE3
A26 | IDSEL
B27 | AD23
A28 | AD22

VCC_+3.3V | 1
MSEL0 | 2

A29 | AD20
B30 | AD19

1 | STROBE
2 | DATA0

B35 | IRDY#

8 | DATA6

10 | ACK
11 | BUSY

B44 | CBE1
A44 | AD15

13 | SELT

A46 | AD13
B47 | AD12
A47 | AD11
B48 | AD10
A49 | AD9
B52 | AD8
A52 | CBE0

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

15 | ERR

17 | SELIN

NC | 9
DATA0 | 7
GND | 10

19 | GND
20 | GND
21 | GND

23 | GND

1 | DCD
6 | DSR

7 | RTS

5 | GND

VCC_+5V | 1

Êîíòðîëëåð óíèâåðñàëüíûõ èíòåðôåéñîâ íà îòå÷åñòâåííîé ÏËÈÑ Ñõåìà ýëåêòðè÷åñêàÿ ïðèíöèïèàëüíàÿ | Ëèò. | Ìàññà | Ìàñøòàá

Èçì. | Ëèñò | ¹ äîêóì. | Ïîäï. | Äàòà
Ðàçðàá. | | Ñóëòàíîâ È.À.
Ïðîâ. | | Øïèåâ Â.À.
Ò.êîíòð. | | | | | Ëèñò | Ëèñòîâ 1

Í.êîíòð.
Óòâ.

ÌÃÒÓ èì. Í.Ý. Áàóìàíà Ãðóïïà ÈÓ4-47
