VendeinRaZoR/PCI_COM_LPT/Schematics XC4T/Cadence Allegro/pci_com_lpt_top.pdf

## I672YEL_GREEN YEL_GREEN YEL_GREEN

# AUX 8

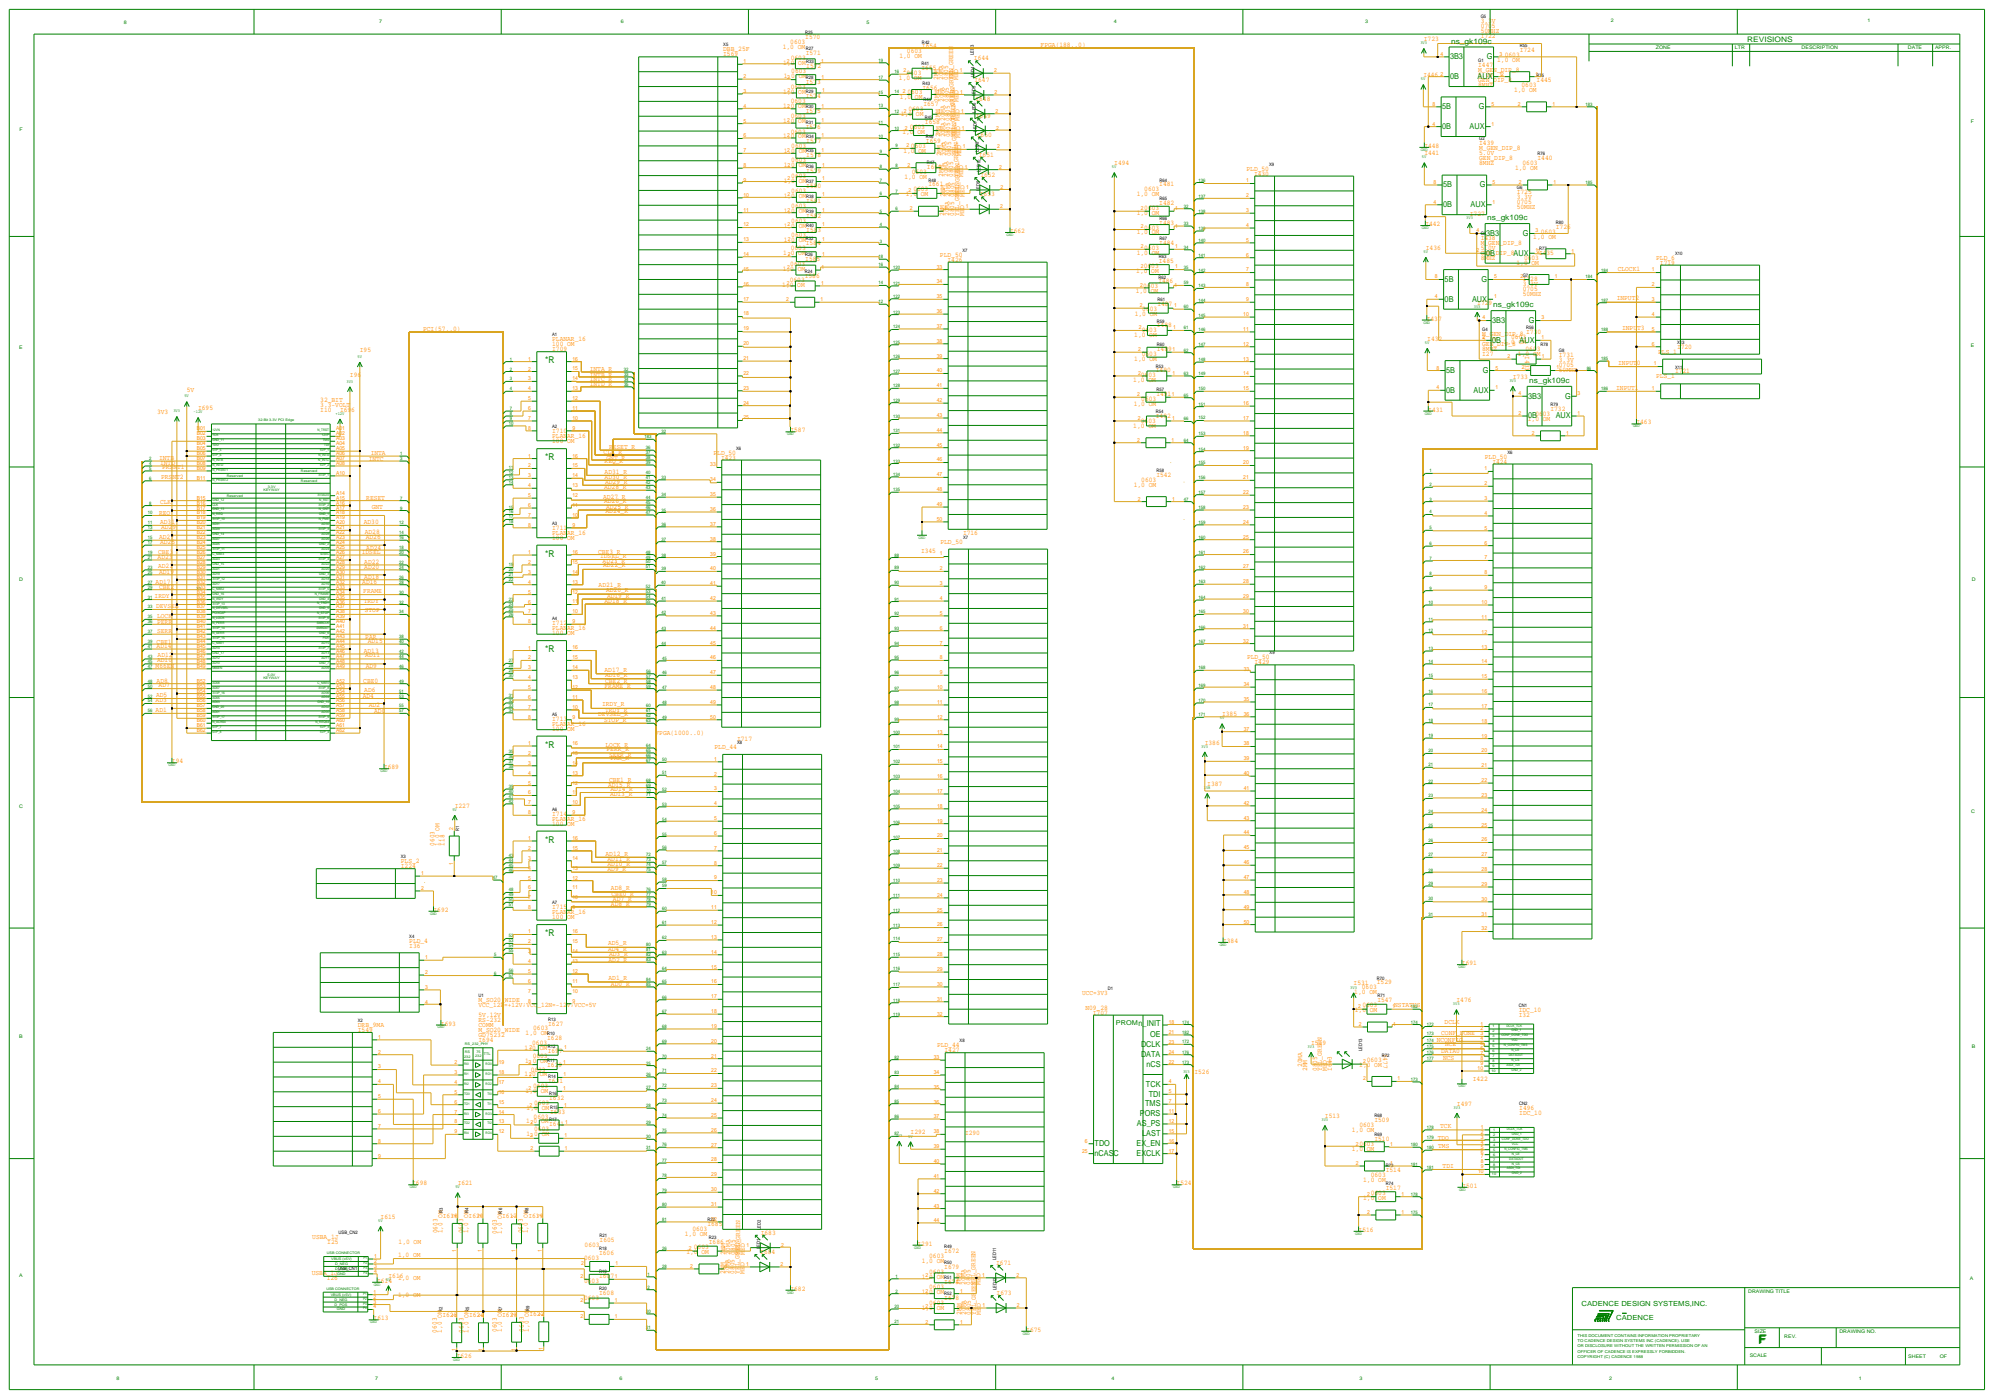
[picture p17: page 1]

8 8 | 7 7 | 6 6 | 5 5 R25 R25 | 4 4 | G5 G5 3.3V 3.3V 3 3 50MHZ 50MHZ | 2 2 | 1 1

I570 | REVISIONS

5B 5B 0B 0B | G G AUX I729 3V3 I729 3V3

3B3 3B3 0B 0B 1,0 OM 1,0 OM | G G R56 R56 I730 I730 0603 0603 AUX AUX

3B3 3B3 0B 0B | G G R79 R79 I732 I732 AUX AUX

12VN | N_TRST

KEYWAY 3.3V

Reserved | | 3V3AUX

AD25 | GND_2
3V3P_11 | AD24
B26 B26 B27 B27 B28 B28

AD23 | 3V3P_4
GND_15 | AD22
AD21 | AD20

3V3P_12 | AD18
AD17 | AD16

GND_16 | N_FRAME
N_IRDY | GND_4

N_DEVSEL | GND_5
PCIXCAP | N_STOP
N_LOCK | 3V3P_6
N_PERR | SMBCLK

A38 A38 A39 A39 | STOP

GND_20 | AD02
AD01 | AD00
3V3P_17 | 3V3P_9

2 2 | GND_1
3 3 | CONF_DONE_TDO

5 5 | N_CONFIG_TMS
6 6 | N_CE
7 7 | DATAOUT

VBUS (+5V) | P1 P1
D_NEG | P2 P2
USB_CN1 D_POS D_POS | P3 P3 | 4 USB_CN1

D_POS | P3 P3
GND | P4 P4

CADENCE DESIGN SYSTEMS,INC.

SIZE SIZE FF FF | REV. | DRAWING NO.

THIS DOCUMENT CONTAINS INFORMATION PROPRIETARY
TO CADENCE DESIGN SYSTEMS INC (CADENCE). USE
OR DISCLOSURE WITHOUT THE WRITTEN PERMISSION OF AN
OFFICER OF CADENCE IS EXPRESSLY FORBIDDEN.
COPYRIGHT (C) CADENCE 1988

SCALE | | SHEET SHEET OF OF

## DCB

# I/O118 I/O87

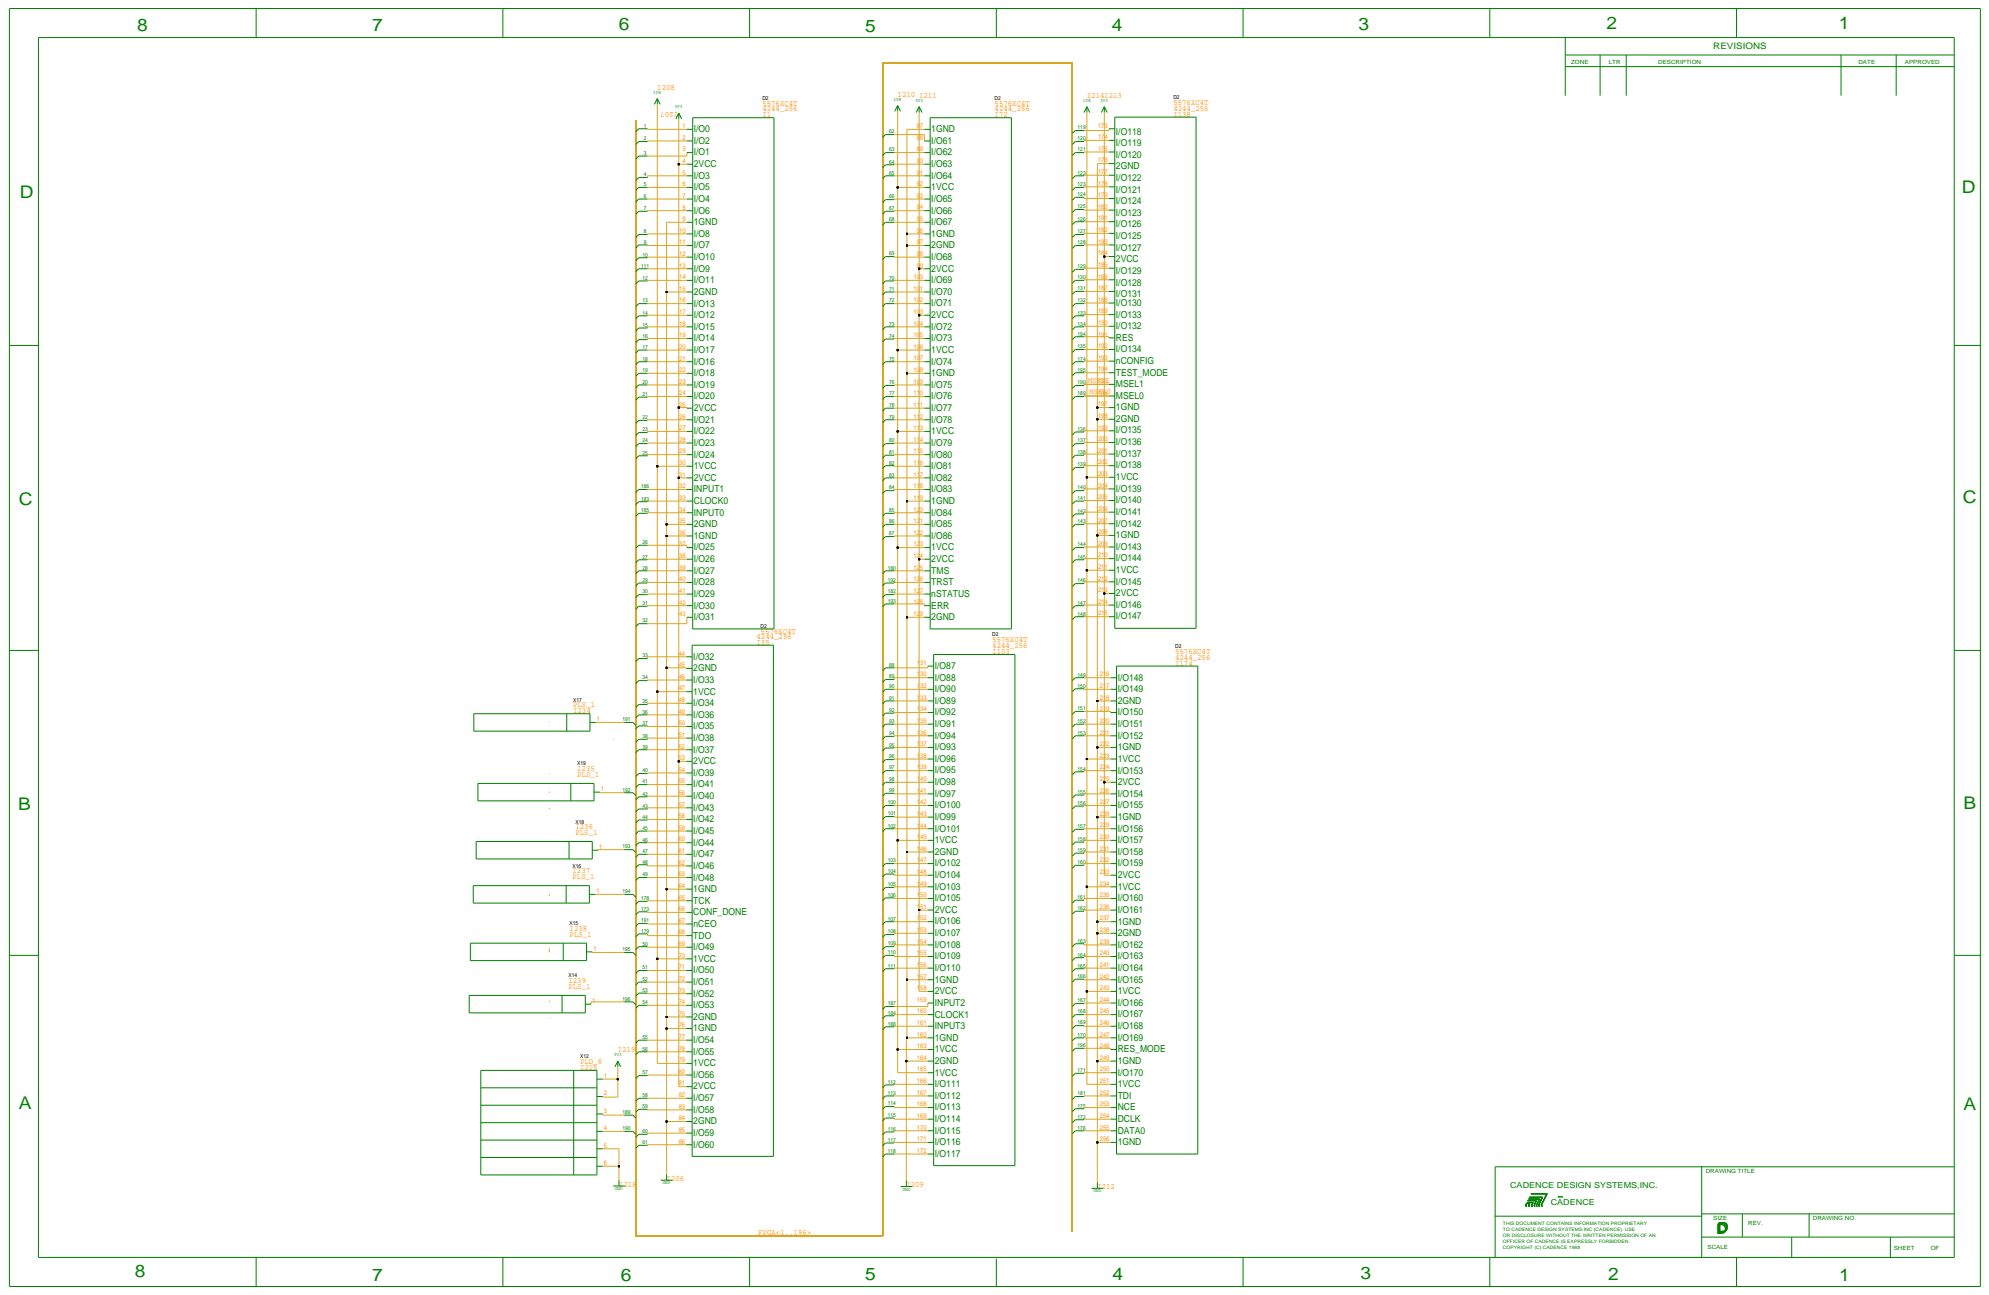
[picture p18: page 2]
MSEL0; MSEL1; FPGA<1..196>; GND; I212 GND; I218 GND; PLD_6; PLS_1; I235 PLS_1; I236 PLS_1; I238 PLS_1; DCBA; 2GND; ERR; nSTATUS; TRST; TMS; 2VCC; 1VCC; 1GND; TDO; nCEO; CONF_DONE; TCK; DATA0; DCLK; NCE; TDI; RES_MODE; TEST_MODE; nCONFIG; RES; INPUT3; CLOCK1; INPUT2; INPUT0; CLOCK0; INPUT1; DCB

REVISIONS

ZONE | LTR | DESCRIPTION | DATE | APPROVED

97 97
98 98 99 99

223
224 224 225 225

146
147 147 148 148 149 149 150 150 151 151

76 76
77 77 78 78 79 79

CADENCE DESIGN SYSTEMS,INC. CADENCE DESIGN SYSTEMS,INC. CADENCE CADENCE | DRAWING TITLE DD

SIZE | REV. | DRAWING NO.

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

SCALE | | SHEET SHEET OF OF

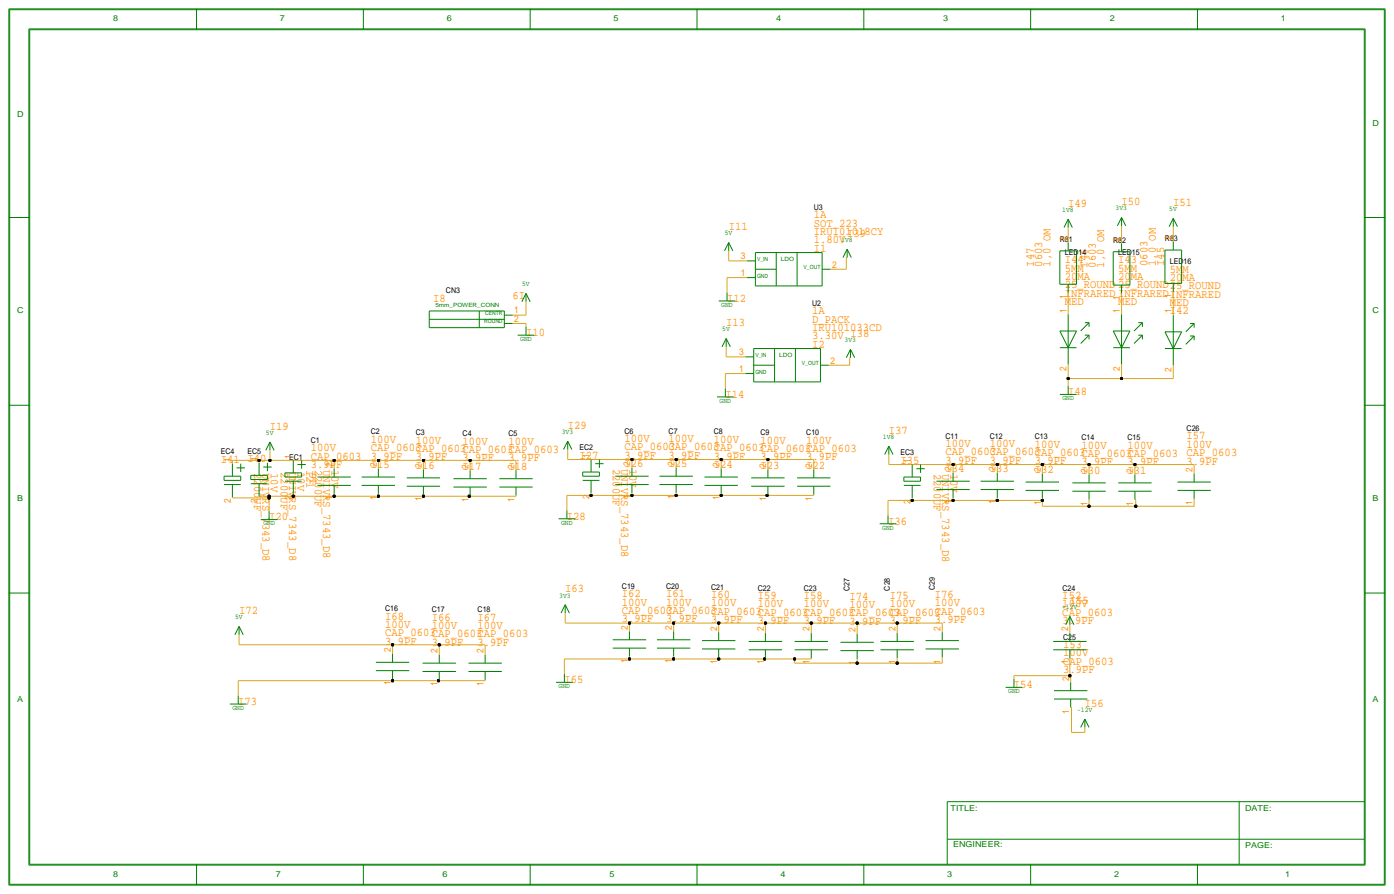
[picture p19: page 3]

CENTR
ROUND

TITLE: | DATE:

ENGINEER: | PAGE:
