VendeinRaZoR/PCI_COM_LPT/Schematics Cyclone III/Алгоритм логического проекта.pdf

# Íà÷àëî

1

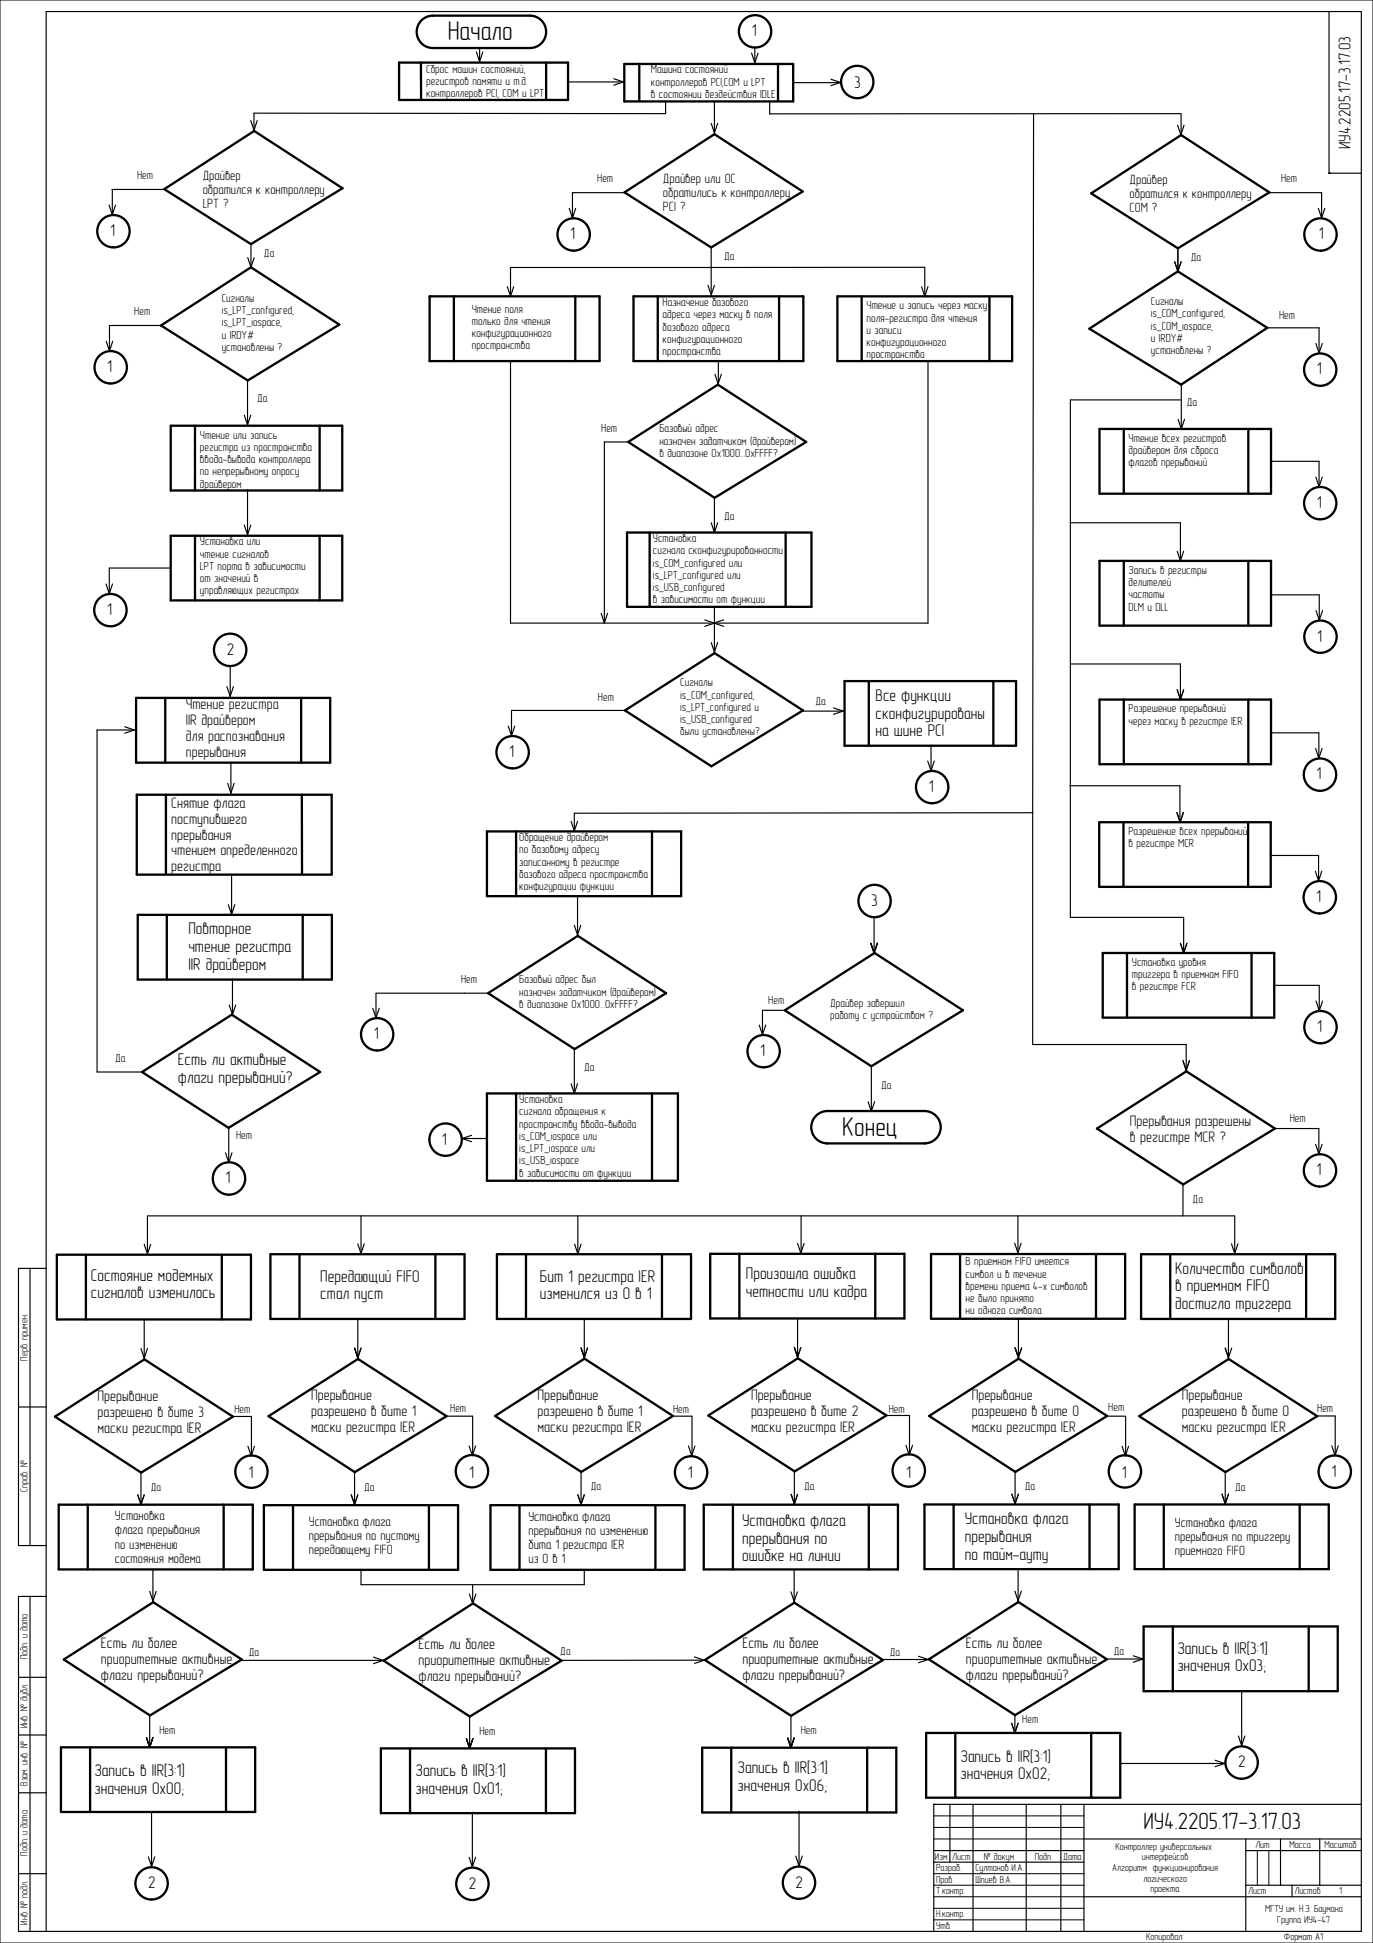
[picture p20: page 1]
Êîïèðîâàë:; Ôîðìàò À1; Ñèãíàëû is_LPT_configured, is_LPT_iospace, è IRDY# óñòàíîâëåíû ?; Íåò; Äðàéâåð îáðàòèëñÿ ê êîíòðîëëåðó LPT ?; Ñèãíàëû is_COM_configured, is_COM_iospace, è IRDY# óñòàíîâëåíû ?; Óñòàíîâêà ñèãíàëà ñêîíôèãóðèðîâàííîñòè is_COM_configured èëè is_LPT_configured èëè is_USB_configured â çàâèñèìîñòè îò ôóíêöèè; Ñèãíàëû is_COM_configured, is_LPT_configured è is_USB_configured áûëè óñòàíîâëåíû?; Áàçîâûé àäðåñ áûë; Çàïèñü â ðåãèñòðû äåëèòåëåé ÷àñòîòû DLM è DLL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

Ñáðîñ ìàøèí ñîñòîÿíèé,
ðåãèñòðîâ ïàìÿòè è ò.ä.
êîíòðîëëåðîâ PCI, COM è LPT

Ìàøèíà ñîñòîÿíèé
êîíòðîëëåðîâ PCI,COM è LPT
â ñîñòîÿíèè áåçäåéñòâèÿ IDLE

Äðàéâåð èëè ÎÑ
îáðàòèëèñü ê êîíòðîëëåðó
PCI ?

Íàçíà÷åíèå áàçîâîãî
àäðåñà ÷åðåç ìàñêó â ïîëÿ
áàçîâîãî àäðåñà
êîíôèãóðàöèîííîãî
ïðîñòðàíñòâà

×òåíèå è çàïèñü ÷åðåç ìàñêó
ïîëÿ-ðåãèñòðà äëÿ ÷òåíèÿ
è çàïèñè

×òåíèå ïîëÿ
òîëüêî äëÿ ÷òåíèÿ

Áàçîâûé àäðåñ
íàçíà÷åí çàäàò÷èêîì (äðàéâåðîì)
â äèàïàçîíå 0x1000...0xFFFF?

×òåíèå èëè çàïèñü
ðåãèñòðà èç ïðîñòðàíñòâà
ââîäà-âûâîäà êîíòðîëëåðà
ïî íåïðåðûâíîìó îïðîñó
äðàéâåðîì

×òåíèå âñåõ ðåãèñòðîâ
äðàéâåðîì äëÿ ñáðîñà
ôëàãîâ ïðåðûâàíèé

Óñòàíîâêà èëè
÷òåíèå ñèãíàëîâ
LPT ïîðòà â çàâèñèìîñòè
îò çíà÷åíèé â
óïðàâëÿþùèõ ðåãèñòðàõ

Âñå ôóíêöèè
ñêîíôèãóðèðîâàíû
íà øèíå PCI

Ðàçðåøåíèå ïðåðûâàíèé
÷åðåç ìàñêó â ðåãèñòðå IER

Ðàçðåøåíèå âñåõ ïðåðûâàíèé
â ðåãèñòðå MCR

Îáðàùåíèå äðàéâåðîì
ïî áàçîâîìó àäðåñó
çàïèñàííîìó â ðåãèñòðå
áàçîâîãî àäðåñà ïðîñòðàíñòâà
êîíôèãóðàöèè ôóíêöèè

Óñòàíîâêà óðîâíÿ
òðèããåðà â ïðèåìíîì FIFO
â ðåãèñòðå FCR

Óñòàíîâêà
ñèãíàëà îáðàùåíèÿ ê
ïðîñòðàíñòâó ââîäà-âûâîäà
is_COM_iospace èëè
is_LPT_iospace èëè
is_USB_iospace
â çàâèñèìîñòè îò ôóíêöèè

Íåò Ïðåðûâàíèÿ ðàçðåøåíû
â ðåãèñòðå MCR ?

Â ïðèåìíîì FIFO èìååòñÿ
ñèìâîë è â òå÷åíèå
âðåìåíè ïðèåìà 4-õ ñèìâîëîâ
íå áûëî ïðèíÿòî
íè îäíîãî ñèìâîëà

Êîëè÷åñòâî ñèìâîëîâ
â ïðèåìíîì FIFO
äîñòèãëî òðèããåðà

Ïðîèçîøëà îøèáêà
÷åòíîñòè èëè êàäðà

Áèò 1 ðåãèñòðà IER
èçìåíèëñÿ èç 0 â 1

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

Ïðåðûâàíèå
ðàçðåøåíî â áèòå 3
ìàñêè ðåãèñòðà IER

ðàçðåøåíî â áèòå 1

ðàçðåøåíî â áèòå 2

ðàçðåøåíî â áèòå 0

Óñòàíîâêà ôëàãà
ïðåðûâàíèÿ ïî èçìåíåíèþ
áèòà 1 ðåãèñòðà IER

ïðåðûâàíèÿ ïî
îøèáêå íà ëèíèè

ïðåðûâàíèÿ
ïî òàéì-àóòó

ïðåðûâàíèÿ ïî ïóñòîìó
ïåðåäàþùåìó FIFO

ïðåðûâàíèÿ ïî òðèããåðó
ïðèåìíîãî FIFO

Åñòü ëè áîëåå
ïðèîðèòåòíûå àêòèâíûå
ôëàãè ïðåðûâàíèé?

çíà÷åíèÿ 0x02; Çàïèñü â IIR[3:1]
çíà÷åíèÿ 0x06;

Êîíòðîëëåð óíèâåðñàëüíûõ èíòåðôåéñîâ Àëãîðèòì ôóíêöèîíèðîâàíèÿ ëîãè÷åñêîãî ïðîåêòà | Ëèò. | Ìàññà | Ìàñøòàá

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

ÌÃÒÓ èì. Í.Ý. Áàóìàíà Ãðóïïà ÈÓ4-47

Í.êîíòð.
Óòâ.
