VendeinRaZoR/PCI_COM_LPT/Schematics Cyclone III/Алгоритм работы устройства.pdf

## Íà÷àëî

2

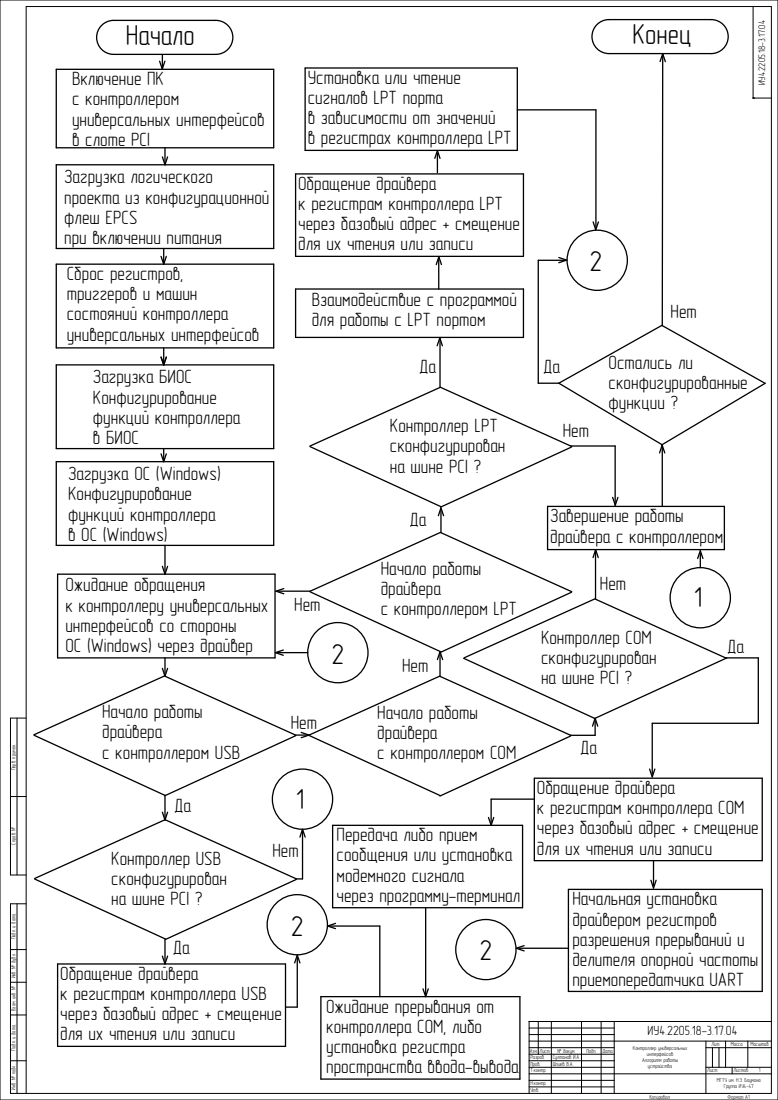
[picture p21: page 1]
Êîïèðîâàë:; Ôîðìàò À1; Ñáðîñ ðåãèñòðîâ, òðèããåðîâ è ìàøèí ñîñòîÿíèé êîíòðîëëåðà óíèâåðñàëüíûõ èíòåðôåéñîâ; Çàãðóçêà ÁÈÎÑ Êîíôèãóðèðîâàíèå ôóíêöèé êîíòðîëëåðà â ÁÈÎÑ; Íåò; Çàâåðøåíèå ðàáîòû äðàéâåðà ñ êîíòðîëëåðîì; Îñòàëèñü ëè ñêîíôèãóðèðîâàííûå ôóíêöèè ?; Êîíåö

Âêëþ÷åíèå ÏÊ
ñ êîíòðîëëåðîì
óíèâåðñàëüíûõ èíòåðôåéñîâ
â ñëîòå PCI

Óñòàíîâêà èëè ÷òåíèå
ñèãíàëîâ LPT ïîðòà
â çàâèñèìîñòè îò çíà÷åíèé
â ðåãèñòðàõ êîíòðîëëåðà LPT

Çàãðóçêà ëîãè÷åñêîãî
ïðîåêòà èç êîíôèãóðàöèîííîé
ôëåø EPCS
ïðè âêëþ÷åíèè ïèòàíèÿ

Îáðàùåíèå äðàéâåðà
ê ðåãèñòðàì êîíòðîëëåðà LPT
÷åðåç áàçîâûé àäðåñ + ñìåùåíèå
äëÿ èõ ÷òåíèÿ èëè çàïèñè

Âçàèìîäåéñòâèå ñ ïðîãðàììîé
äëÿ ðàáîòû ñ LPT ïîðòîì

Êîíòðîëëåð LPT
ñêîíôèãóðèðîâàí
íà øèíå PCI ?

Çàãðóçêà ÎÑ (Windows)
Êîíôèãóðèðîâàíèå
ôóíêöèé êîíòðîëëåðà
â ÎÑ (Windows)

Íà÷àëî ðàáîòû
äðàéâåðà
ñ êîíòðîëëåðîì LPT

Îæèäàíèå îáðàùåíèÿ
ê êîíòðîëëåðó óíèâåðñàëüíûõ
èíòåðôåéñîâ ñî ñòîðîíû
ÎÑ (Windows) ÷åðåç äðàéâåð

Êîíòðîëëåð COM

ñ êîíòðîëëåðîì USB

ñ êîíòðîëëåðîì COM

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

ê ðåãèñòðàì êîíòðîëëåðà COM

Ïåðåäà÷à ëèáî ïðèåì
ñîîáùåíèÿ èëè óñòàíîâêà
ìîäåìíîãî ñèãíàëà
÷åðåç ïðîãðàììó-òåðìèíàë

Êîíòðîëëåð USB

Íà÷àëüíàÿ óñòàíîâêà
äðàéâåðîì ðåãèñòðîâ
ðàçðåøåíèÿ ïðåðûâàíèé è
äåëèòåëÿ îïîðíîé ÷àñòîòû
ïðèåìîïåðåäàò÷èêà UART

ê ðåãèñòðàì êîíòðîëëåðà USB

Îæèäàíèå ïðåðûâàíèÿ îò
êîíòðîëëåðà COM, ëèáî
óñòàíîâêà ðåãèñòðà
ïðîñòðàíñòâà ââîäà-âûâîäà

Êîíòðîëëåð óíèâåðñàëüíûõ èíòåðôåéñîâ Àëãîðèòì ðàáîòû óñòðîéñòâà | Ëèò. | Ìàññà | Ìàñøòàá

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

ÌÃÒÓ èì. Í.Ý. Áàóìàíà Ãðóïïà ÈÓ4-47

Í.êîíòð.
Óòâ.
