VendeinRaZoR/PCI_COM_LPT/Schematics Cyclone III/Сборочный чертеж 1.pdf

## Âàðèàíòû óñòàíîâêè ÝÐÝ

## Âàðèàíòû óñòàíîâêè ÝÐÝ

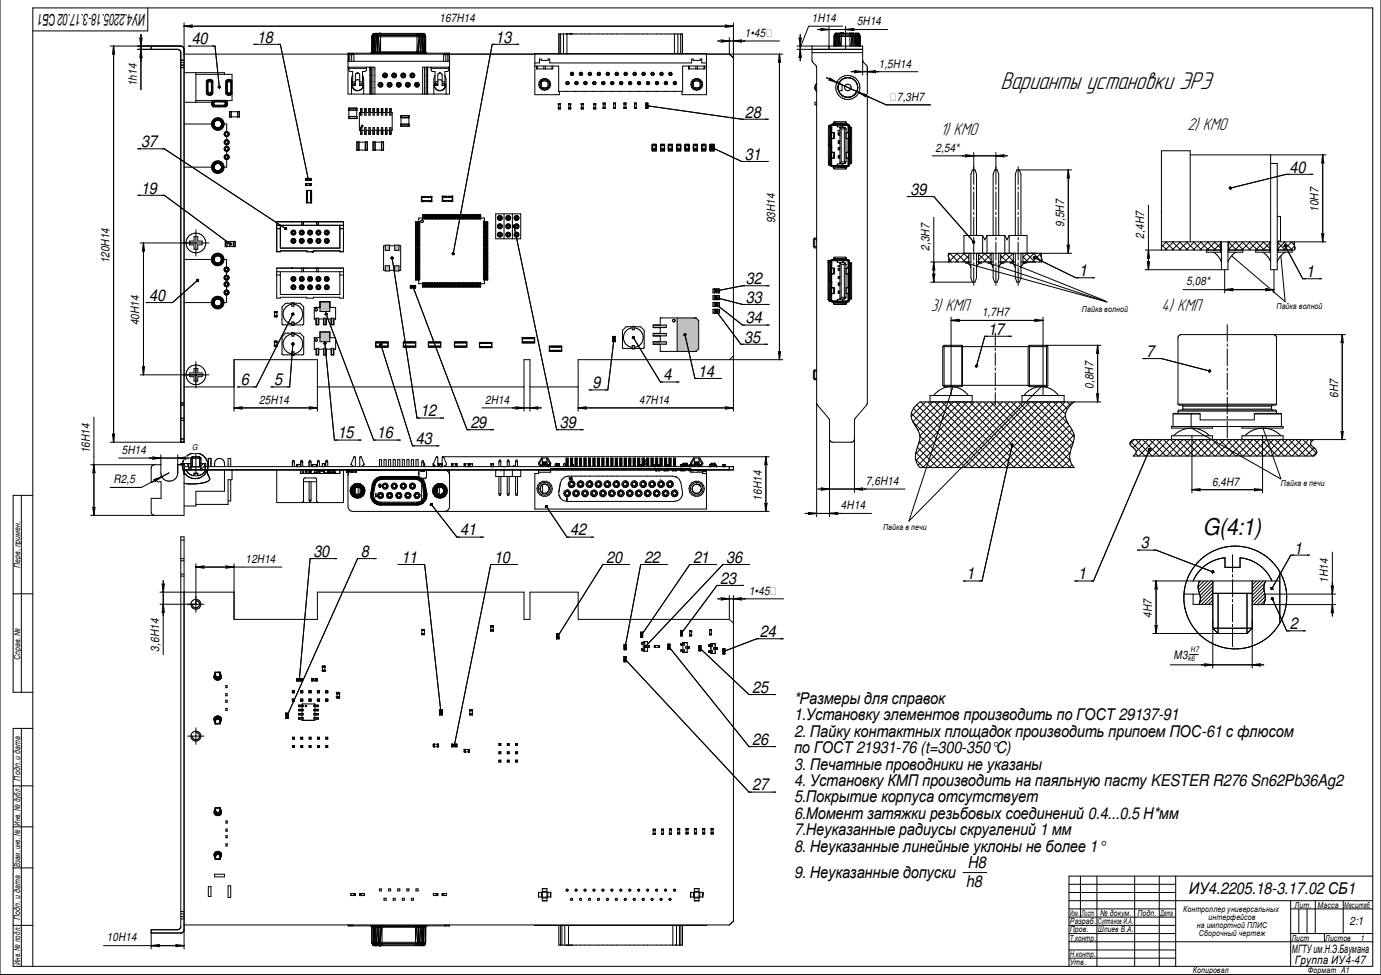
[picture p22: page 1]
1) ÊÌÎ; 2) ÊÌÎ; 3) ÊÌÏ; 4) ÊÌÏ; с флюсом; 9. Неуказанные допуски H8 h8; Пайка волной; Пайка; в печи; Масса Масштаб; Изм. Лист; Лит.; Разраб. Пров.; Т.контр.; Лист; Листов; Н.контр. Утв.; Контроллер универсальных; МГТУ им.Н.Э.Баумана Группа ИУ4-47

Инв. № подл. Подп. и дата Взам. инв. № Инв. № дубл. Подп. и дата Справ. № Перв. примен.

*Размеры для справок
1.Установку элементов производить по ГОСТ 29137-91
2. Пайку контактных площадок производить припоем ПОС-61
по ГОСТ 21931-76 (t=300-350°C)
3. Печатные проводники не указаны
4. Установку КМП производить на паяльную пасту KESTER R276 Sn62Pb36Ag2
5.Покрытие корпуса отсутствует
6.Момент затяжки резьбовых соединений 0.4...0.5
7.Неуказанные радиусы скруглений 1 мм
8. Неуказанные линейные уклоны не более 1°
9. Неуказанные допуски H8 h8

№ докум. Подп. Дата
Султанов
Шпиев

интерфейсов
на импортной ПЛИС
Сборочный чертеж
