VendeinRaZoR/PCI_COM_LPT/Schematics Cyclone III/Схема электрическая структурная.pdf

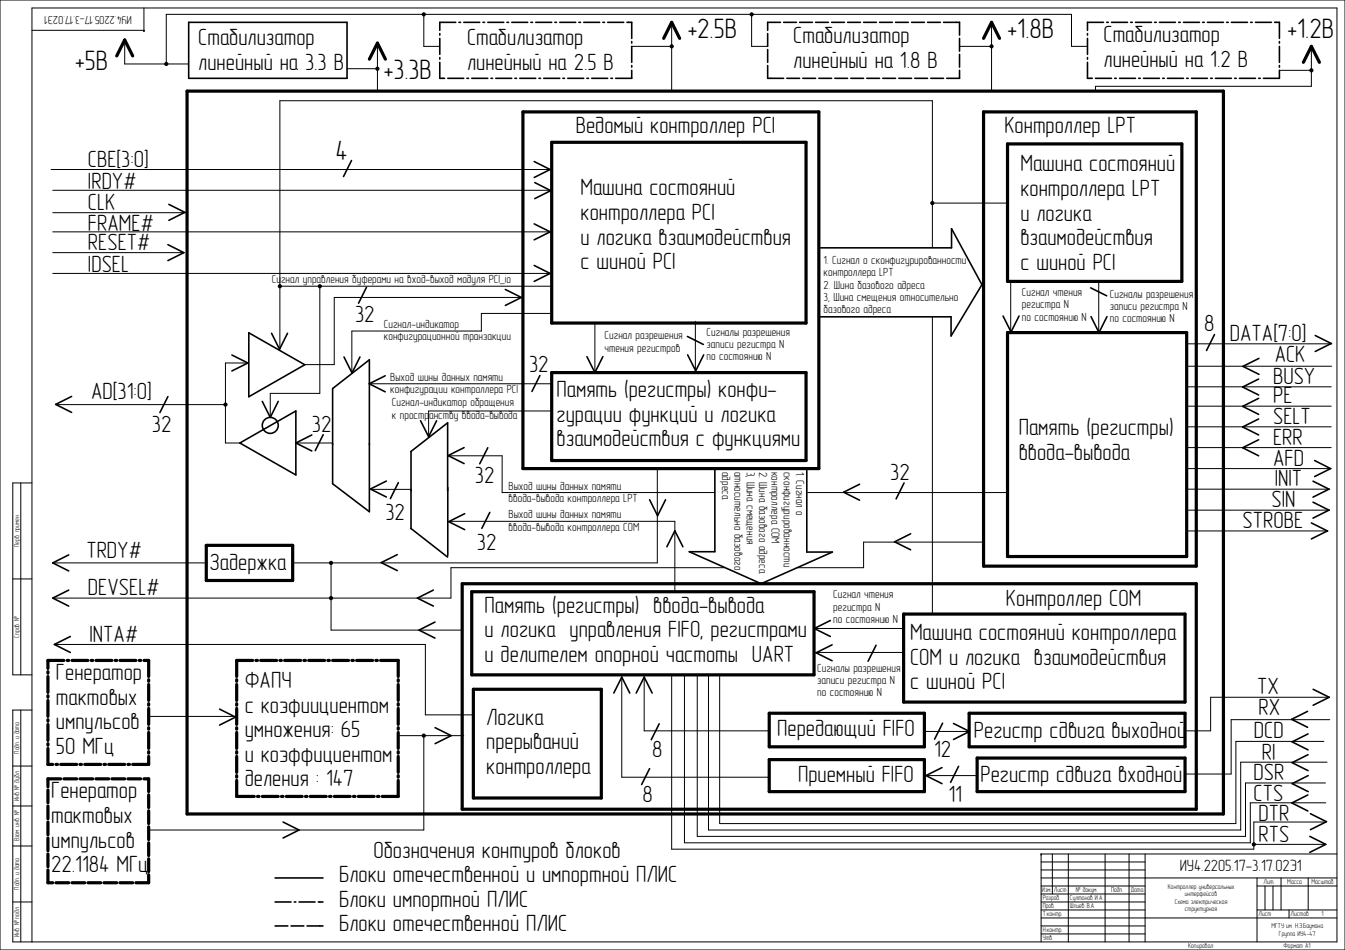
[picture p23: page 1]
Êîïèðîâàë:; Ôîðìàò À1; Ãåíåðàòîð òàêòîâûõ èìïóëüñîâ 50 ÌÃö; Ñòàáèëèçàòîð ëèíåéíûé íà 3.3 Â; Ñòàáèëèçàòîð ëèíåéíûé íà 2.5 Â; Ñòàáèëèçàòîð ëèíåéíûé íà 1.8 Â +3.3Â; Ìàøèíà ñîñòîÿíèé êîíòðîëëåðà PCI è ëîãèêà âçàèìîäåéñòâèÿ ñ øèíîé PCI; CBE[3:0]; IRDY# CLK; Êîíòðîëëåð COM; Êîíòðîëëåð LPT; FRAME# RESET#; Ñòàáèëèçàòîð ëèíåéíûé íà 1.2 Â; ÔÀÏ× ñ êîýôèèöèåíòîì óìíîæåíèÿ: 65 è êîýôôèöèåíòîì äåëåíèÿ : 147; IDSEL; Ãåíåðàòîð òàêòîâûõ èìïóëüñîâ 22.1184 ÌÃö; Ñèãíàëû ðàçðåøåíèÿ çàïèñè ðåãèñòðà N ïî ñîñòîÿíèþ N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

Âåäîìûé êîíòðîëëåð PCI

1. Ñèãíàë î ñêîíôèãóðèðîâàííîñòè
êîíòðîëëåðà LPT
2. Øèíà áàçîâîãî àäðåñà
3, Øèíà ñìåùåíèÿ îòíîñèòåëüíî
áàçîâîãî àäðåñà

Ñèãíàë óïðàâëåíèÿ áóôåðàìè íà âõîä-âûõîä ìîäóëÿ PCI_io

Ñèãíàë ðàçðåøåíèÿ
÷òåíèÿ ðåãèñòðîâ
Ïàìÿòü (ðåãèñòðû) êîíôè-
ãóðàöèè ôóíêöèé è ëîãèêà
âçàèìîäåéñòâèÿ ñ ôóíêöèÿìè

Âûõîä øèíû äàííûõ ïàìÿòè
êîíôèãóðàöèè êîíòðîëëåðà PCI
Ñèãíàë-èíäèêàòîð îáðàùåíèÿ
ê ïðîñòðàíñòâó ââîäà-âûâîäà

ââîäà-âûâîäà êîíòðîëëåðà LPT
ââîäà-âûâîäà êîíòðîëëåðà COM

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

Ïàìÿòü (ðåãèñòðû) ââîäà-âûâîäà
è ëîãèêà óïðàâëåíèÿ FIFO, ðåãèñòðàìè
è äåëèòåëåì îïîðíîé ÷àñòîòû UART

Ìàøèíà ñîñòîÿíèé êîíòðîëëåðà
COM è ëîãèêà âçàèìîäåéñòâèÿ
ñ øèíîé PCI

Ðåãèñòð ñäâèãà âûõîäíîé

Îáîçíà÷åíèÿ êîíòóðîâ áëîêîâ
Áëîêè îòå÷åñòâåííîé è èìïîðòíîé ÏËÈÑ
Áëîêè èìïîðòíîé ÏËÈÑ
Áëîêè îòå÷åñòâåííîé ÏËÈÑ

Êîíòðîëëåð óíèâåðñàëüíûõ èíòåðôåéñîâ Ñõåìà ýëåêòðè÷åñêàÿ ñòðóêòóðíàÿ | Ëèò. | Ìàññà | Ìàñøòàá

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

Í.êîíòð.
Óòâ.

ÌÃÒÓ èì. Í.Ý.Áàóìàíà Ãðóïïà ÈÓ4-47
