VendeinRaZoR/PCI_COM_LPT/Schematics XC4T/Сборочный чертеж 2.pdf

## Âàðèàíòû óñòàíîâêè ÝÐÝ

## Âàðèàíòû óñòàíîâêè ÝÐÝ

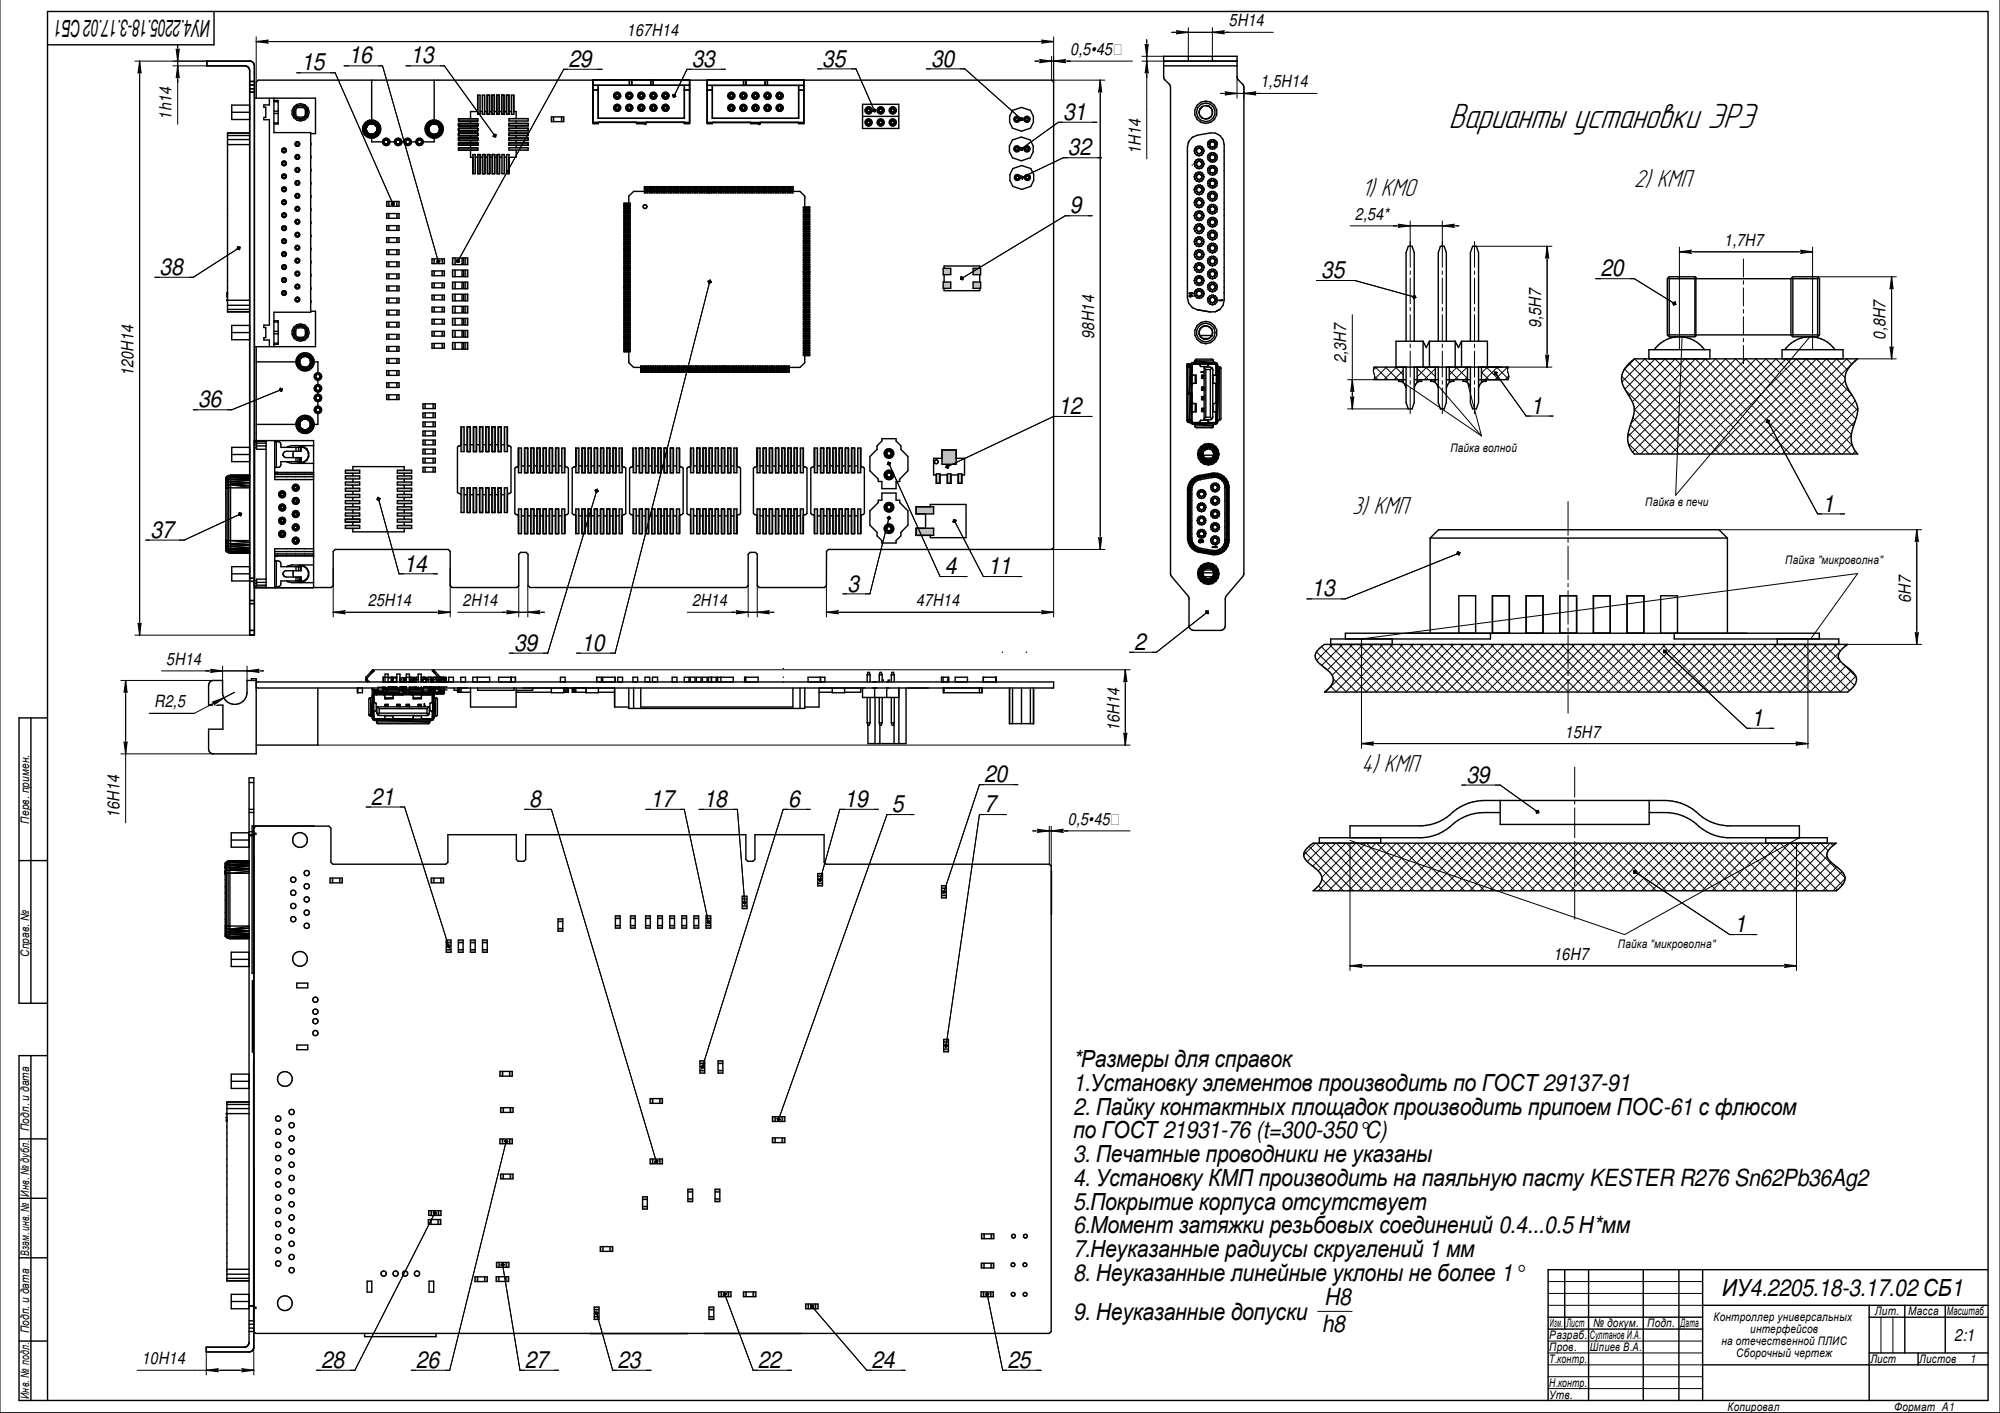
[picture p24: page 1]
9. Неуказанные допуски H8 h8; 1) ÊÌÎ; 2) ÊÌÏ; 3) ÊÌÏ; 4) ÊÌÏ; Пайка "микроволна"; Пайка волной; Пайка в печи; Масса Масштаб; Лит.; Т.контр.; Лист; Листов; Н.контр. Утв.; Контроллер универсальных; Султанов И.А. Шпиев В.А.; Инв.; № подл. Подп.; № Инв.; № дубл. Подп.; Копировал; Формат A1

и дата Справ. № Перв. примен

*Размеры для справок
1.Установку элементов производить по ГОСТ 29137-91
2. Пайку контактных площадок производить припоем ПОС-61 с флюсом
по ГОСТ 21931-76 (t=300-350°C)
3. Печатные проводники не указаны
4. Установку КМП производить на паяльную пасту KESTER R276 Sn62Pb36Ag2
5.Покрытие корпуса отсутствует
6.Момент затяжки резьбовых соединений 0.4...0.5 Н*мм
7.Неуказанные радиусы скруглений 1 мм
8. Неуказанные линейные уклоны не более 1°
9. Неуказанные допуски H8 h8

и дата Взам. инв.

Изм. Лист № докум. Подп. Дата
Разраб.
Пров.

интерфейсов
на отечественной ПЛИС
Сборочный чертеж
