VendeinRaZoR/PCI_COM_LPT/Schematics XC4T/Cadence Allegro/XC4TPCI__pci_lpt_com_route_BOTTOM.pdf

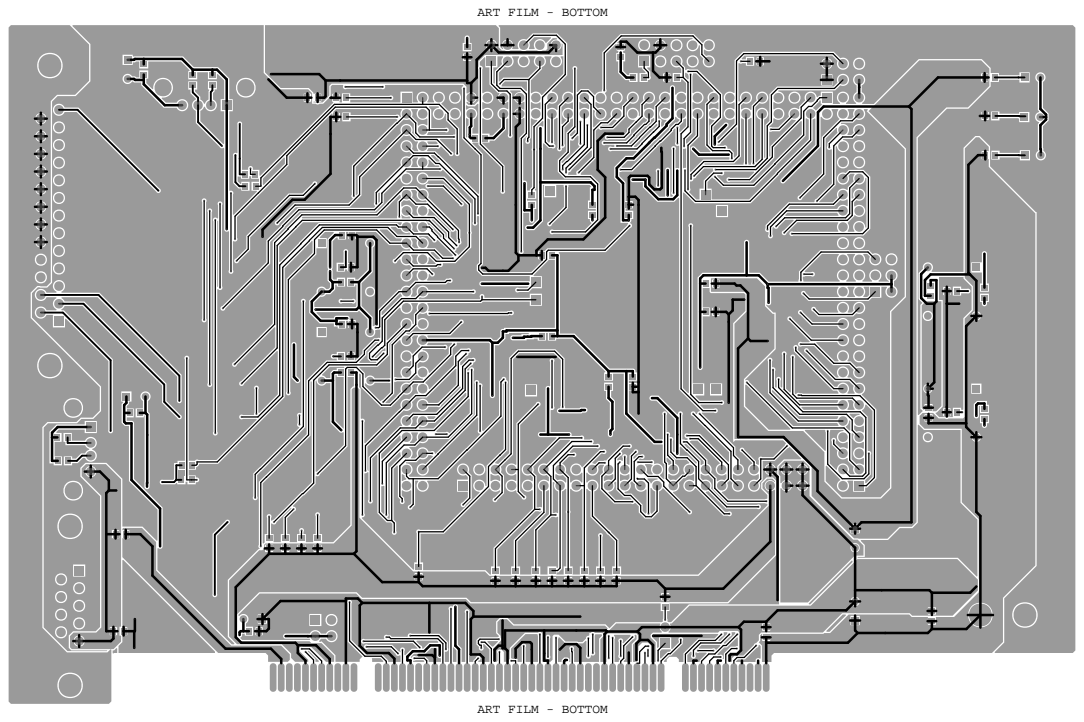
[picture p26: page 1]

ART FILM - BOTTOM
