VendeinRaZoR/PCI_COM_LPT/Schematics XC4T/Cadence Allegro/XC4TPCI__pci_lpt_com_route_TOP.pdf

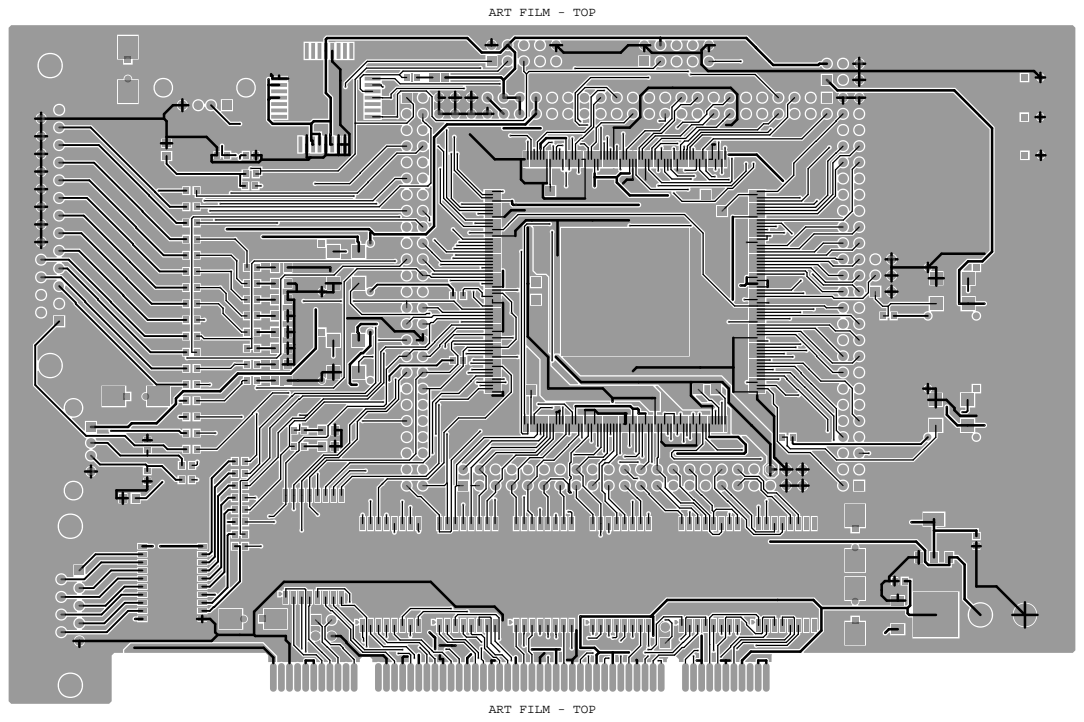
[picture p27: page 1]

ART FILM - TOP
