VendeinRaZoR/PCI_COM_LPT/Version 1.0/Cyclone III/pci_usb_test/simulation/modelsim/rtl_work/altpll0/_primary.vhd

library verilog;
use verilog.vl_types.all;
entity altpll0 is
    port(
        inclk0          : in     vl_logic;
        c0              : out    vl_logic;
        c1              : out    vl_logic
    );
end altpll0;
