VendeinRaZoR/PCI_COM_LPT/Version 1.0/Cyclone III/pci_usb_test/simulation/modelsim/rtl_work/altpll0_altpll/_primary.vhd

library verilog;
use verilog.vl_types.all;
entity altpll0_altpll is
    port(
        clk             : out    vl_logic_vector(4 downto 0);
        inclk           : in     vl_logic_vector(1 downto 0)
    );
end altpll0_altpll;
