VendeinRaZoR/PCI_COM_LPT/(commit log)

2022-02-06 Add Documentations
    [PCIUSB_bottom.gbr, PCIUSB_dimension.gbr, PCIUSB_drill.drl, PCIUSB_mask_bottom.gbr, PCIUSB_mask_top.gbr, PCIUSB_silk_bottom.gbr, PCIUSB_silk_top.gbr, PCIUSB_top.gbr]
2022-02-22 Add XC4T and Update README.md
    [pci_com_lpt_usb_eth.smp_dump.txt, stp1.csv, stp1.stp, stp1_auto_stripped.stp, stp2_auto_stripped.stp, verilog.psm]
